digital0wave/digital0wave.github.smtoaster/README.md

# digital0wave.github.smtoaster

This is a capstone project done at BCIT.

My project partners and I proposed a remotely controlled toaster operated by Arduino. 
It has sensors that detect colour on bread and controls the toastness set by users.
Using HTTP communication, the smart toaster provides users with setting and operating it remotely.
Documents include hardware configuraton, control process, and source codes for HTTP communication.

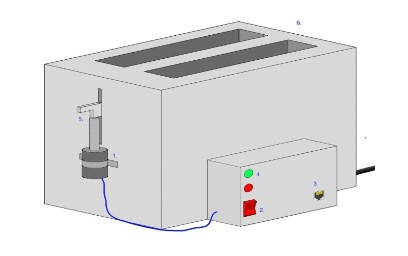
[picture p1: Doc/SMToaster_1.jpg]


## Repo 
├── README.md # This file

├── Doc    # Report and design specs

└── Codes       # Source codes for the firmware
