digital0wave/digital0wave.github.smtoaster/Codes/Doc/division labor.gif

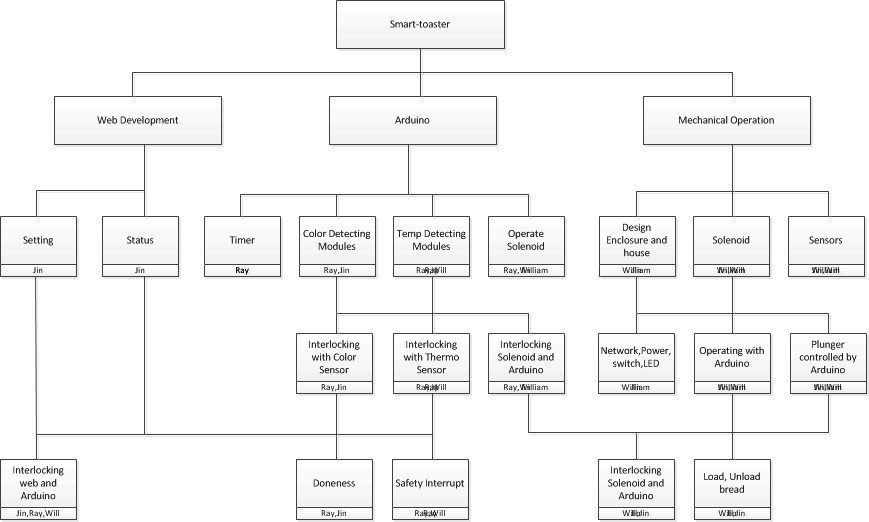
Codes/Doc/division labor.gif
