digital0wave/digital0wave.github.smtoaster/Doc/SmartToaster_C.pdf

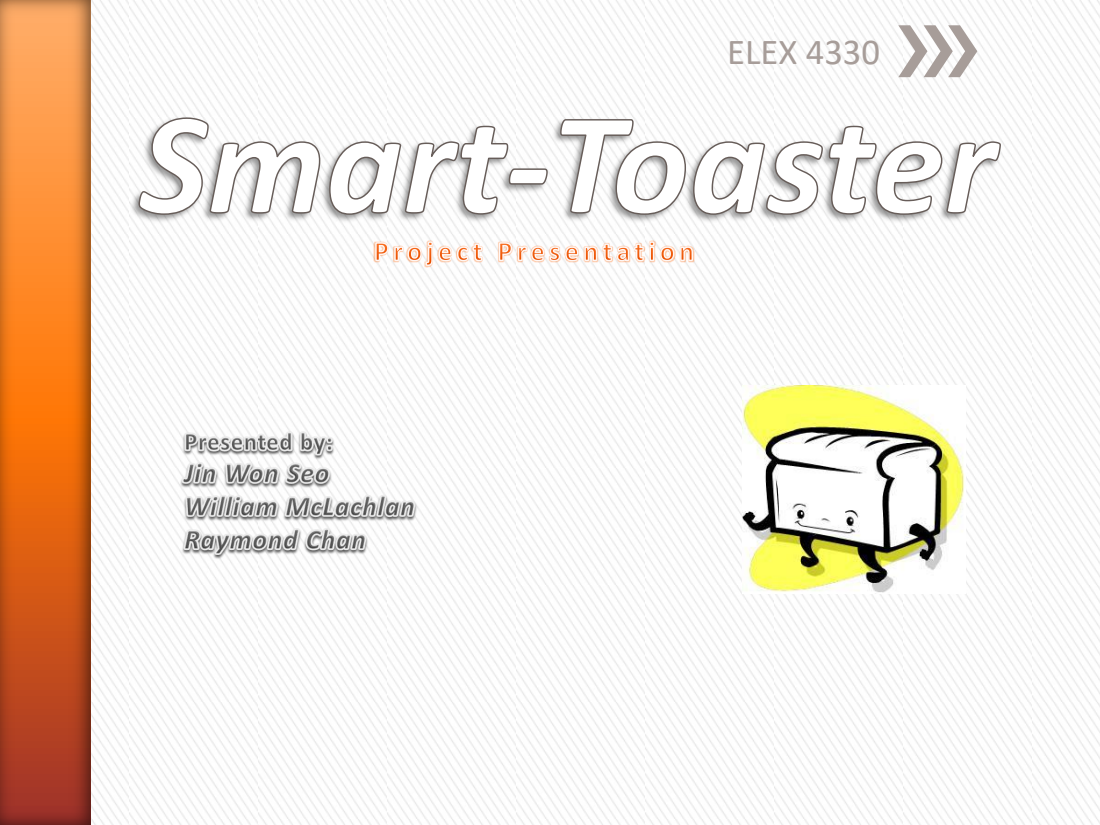
[picture p44: page 1]
ELEX 4330

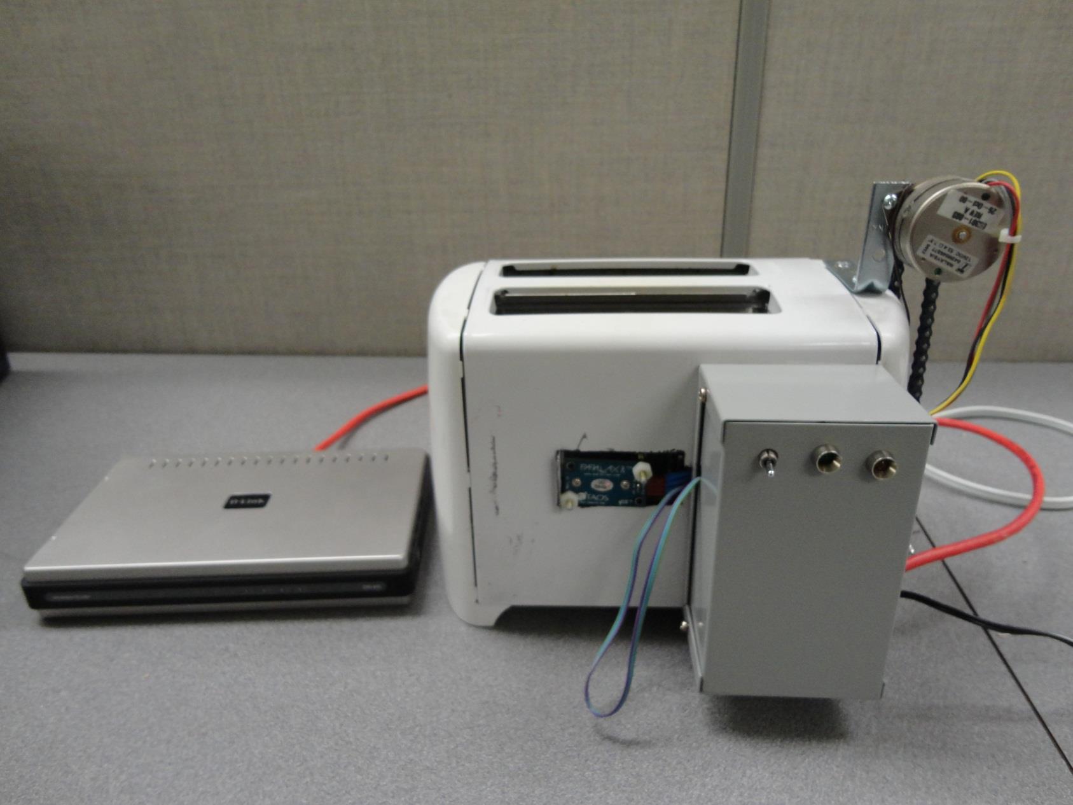
[picture p45: figure]
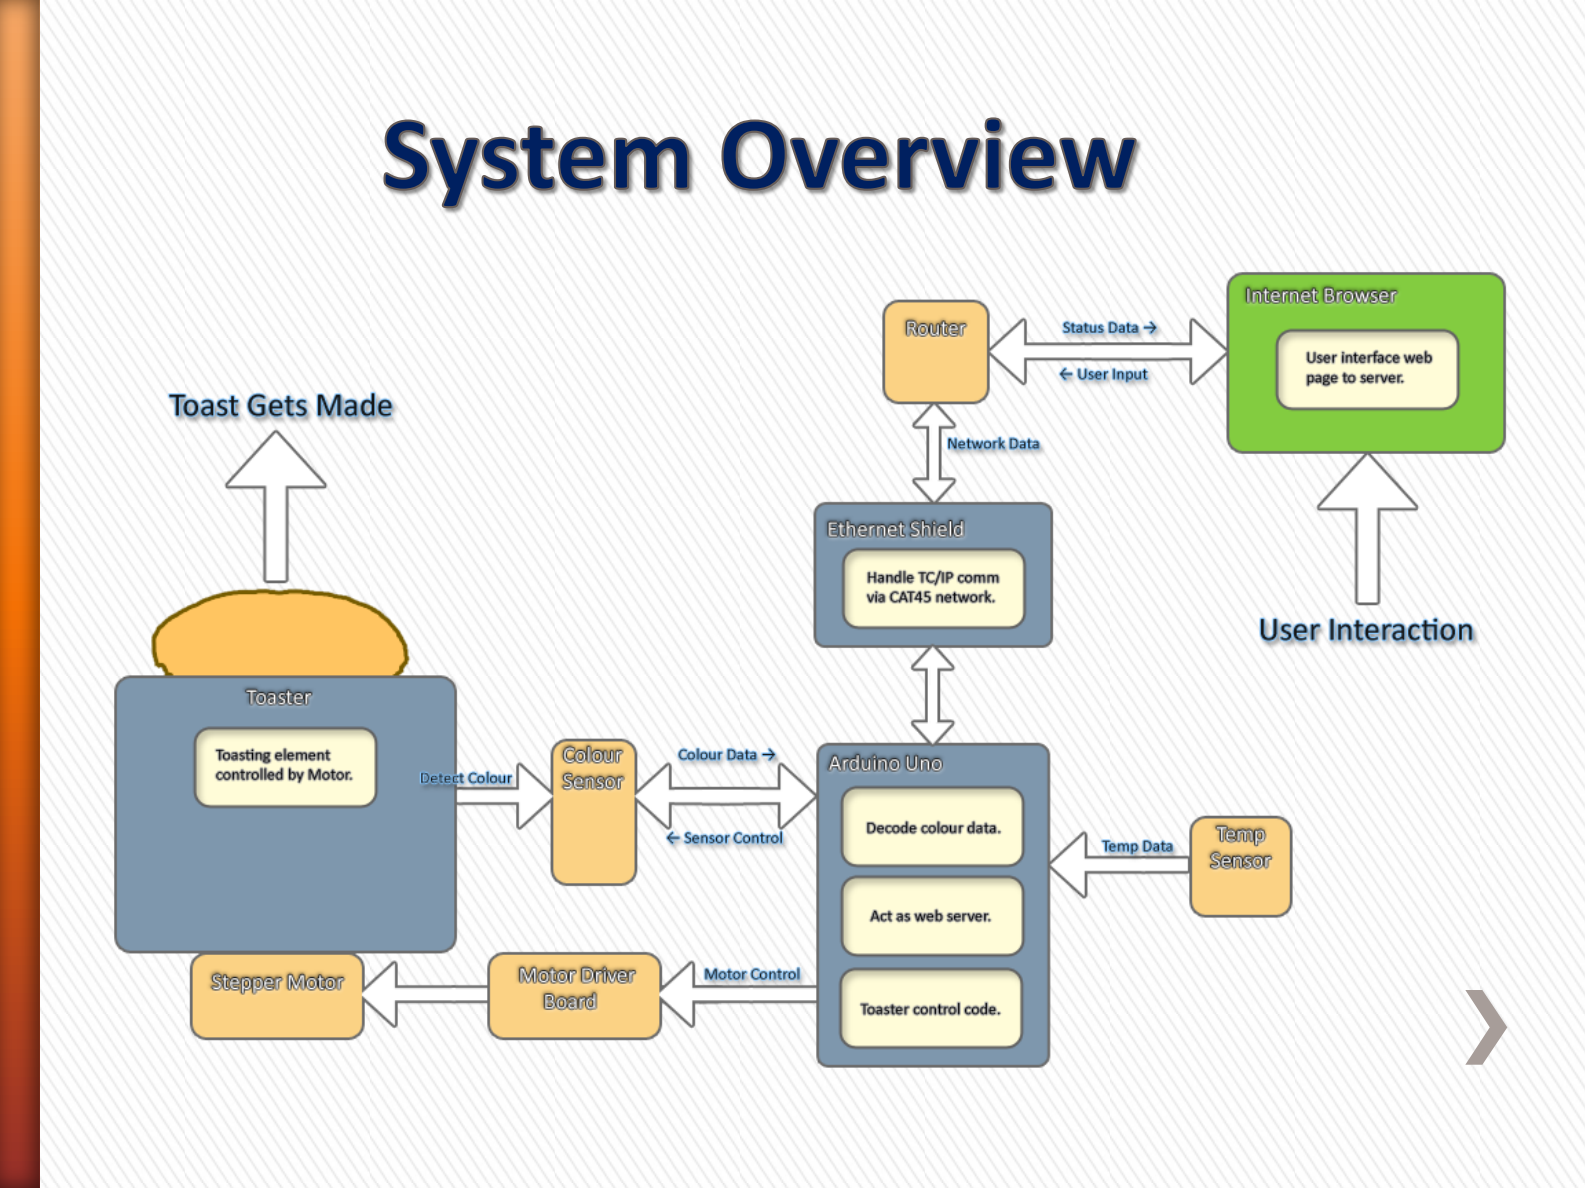
[picture p46: page 3]

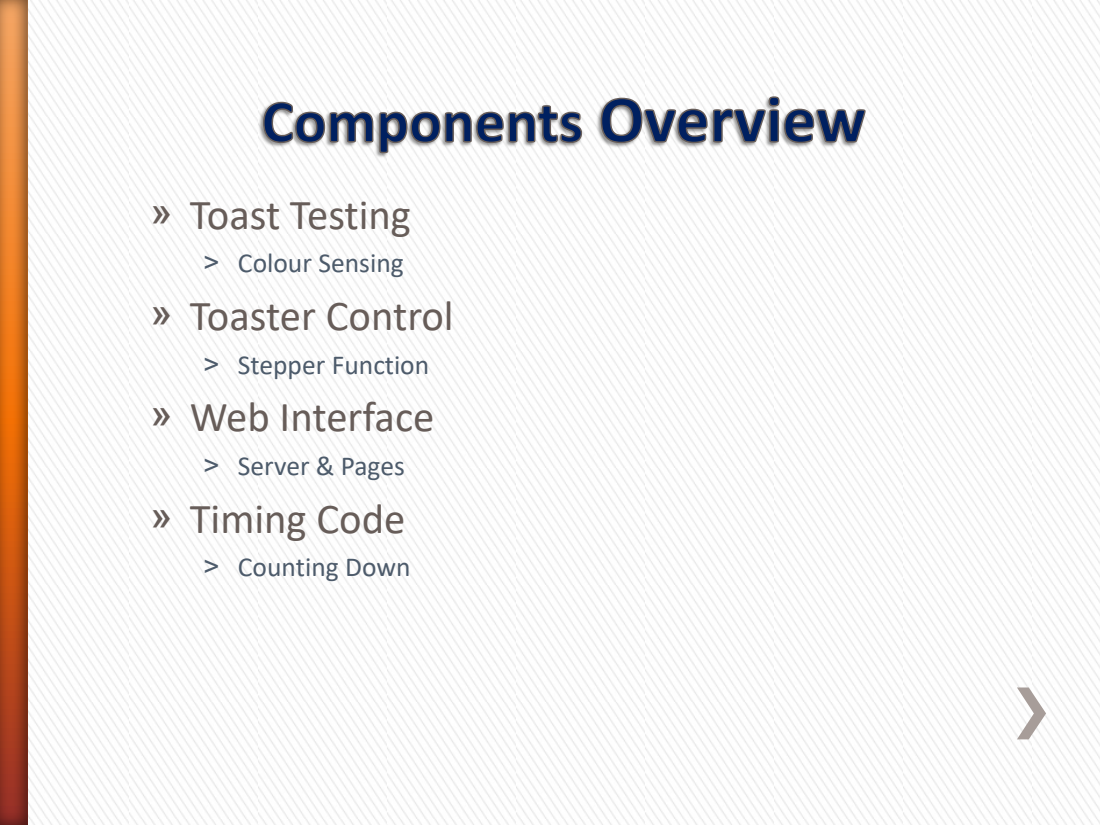
[picture p47: page 4]
» Toast Testing; ˃ Colour Sensing » Toaster Control; ˃ Stepper Function » Web Interface; ˃ Server & Pages » Timing Code; ˃ Counting Down

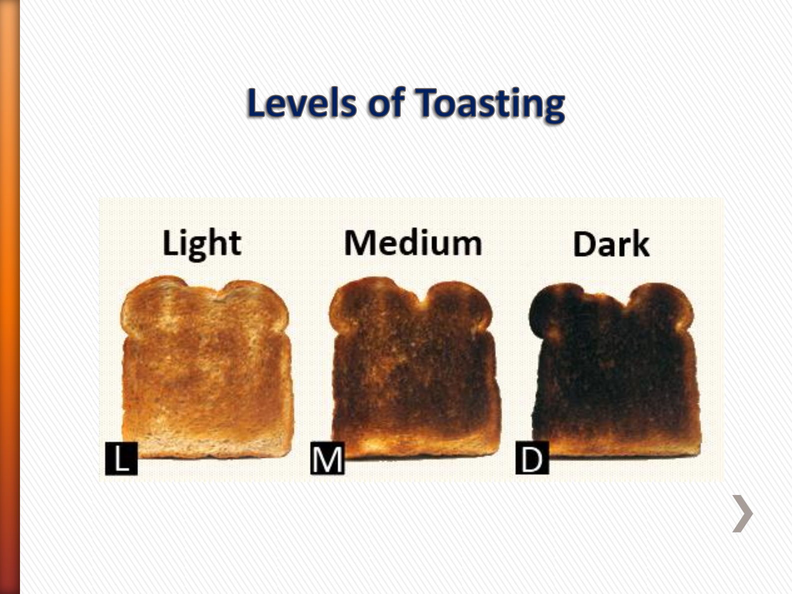
[picture p48: page 5]

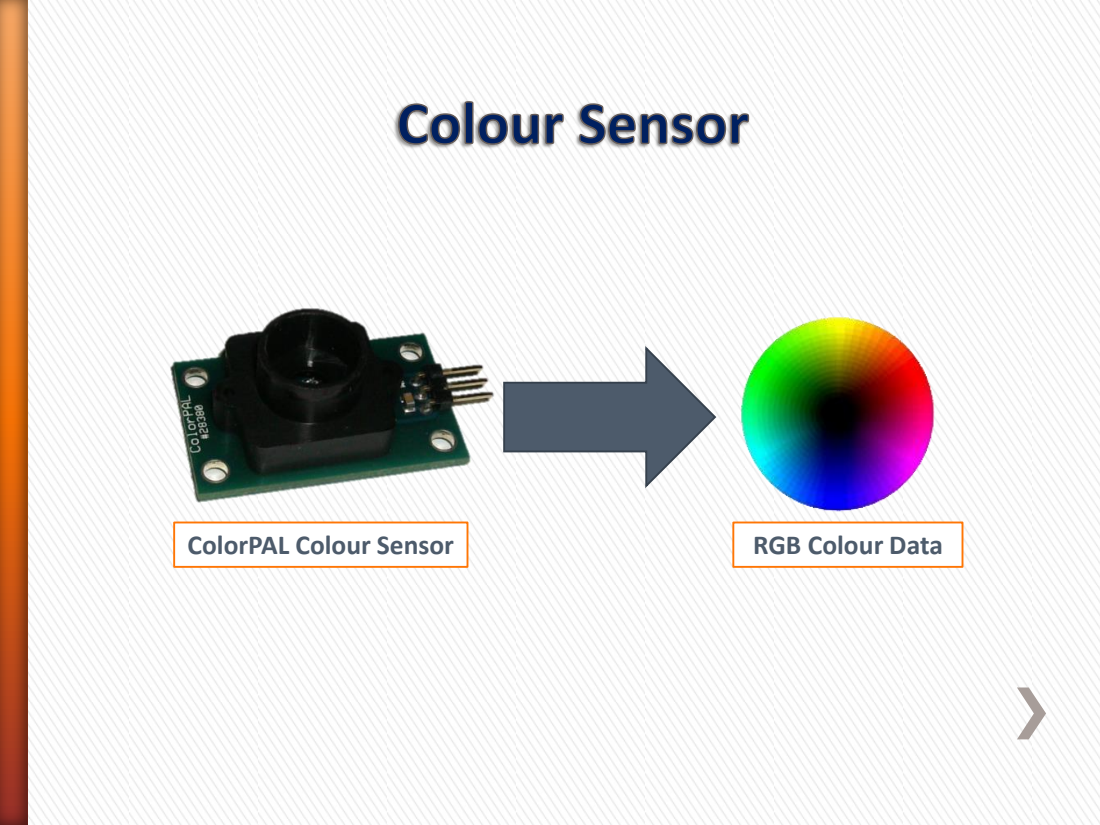
[picture p49: page 6]
ColorPAL Colour Sensor; RGB Colour Data

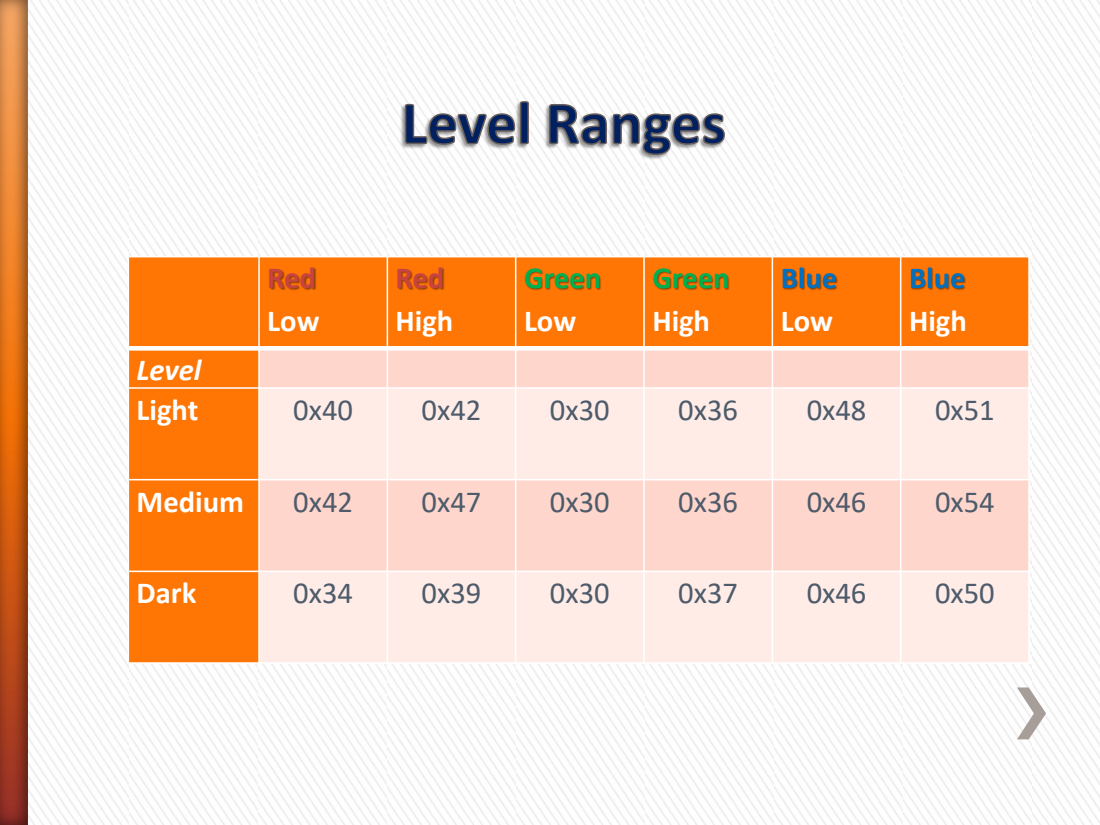
[picture p50: page 7]

Red Low | Red High | Green Low | Green High | Blue Low | Blue High

Level
Light | 0x40 | 0x42 | 0x30 | 0x36 | 0x48 | 0x51

Medium | 0x42 | 0x47 | 0x30 | 0x36 | 0x46 | 0x54

Dark | 0x34 | 0x39 | 0x30 | 0x37 | 0x46 | 0x50

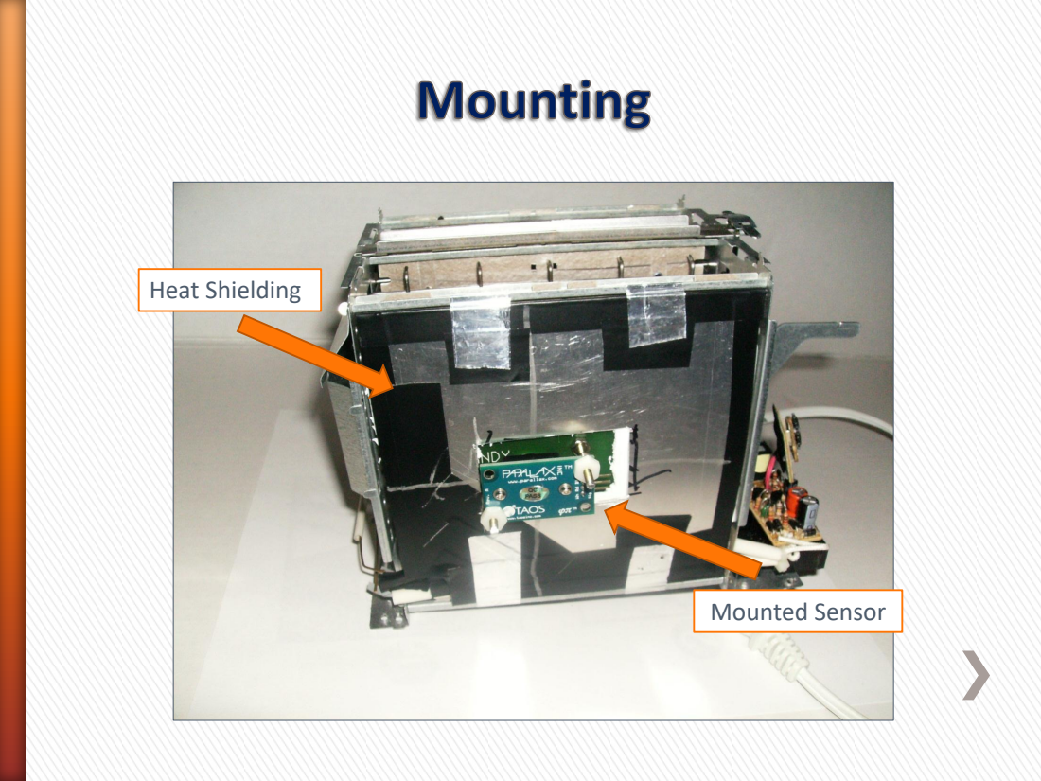
[picture p51: page 8]
Heat Shielding; Mounted Sensor

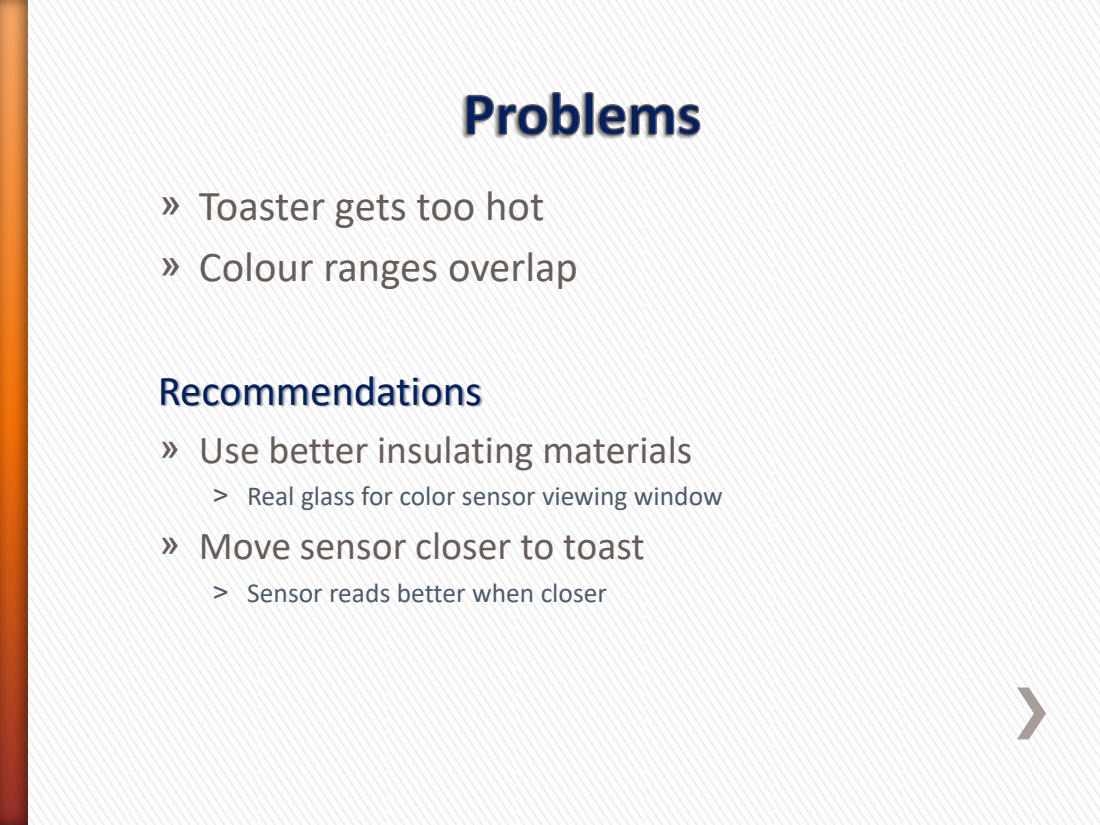
[picture p52: page 9]

» Toaster gets too hot
» Colour ranges overlap

Recommendations
» Use better insulating materials
˃ Real glass for color sensor viewing window
» Move sensor closer to toast
˃ Sensor reads better when closer

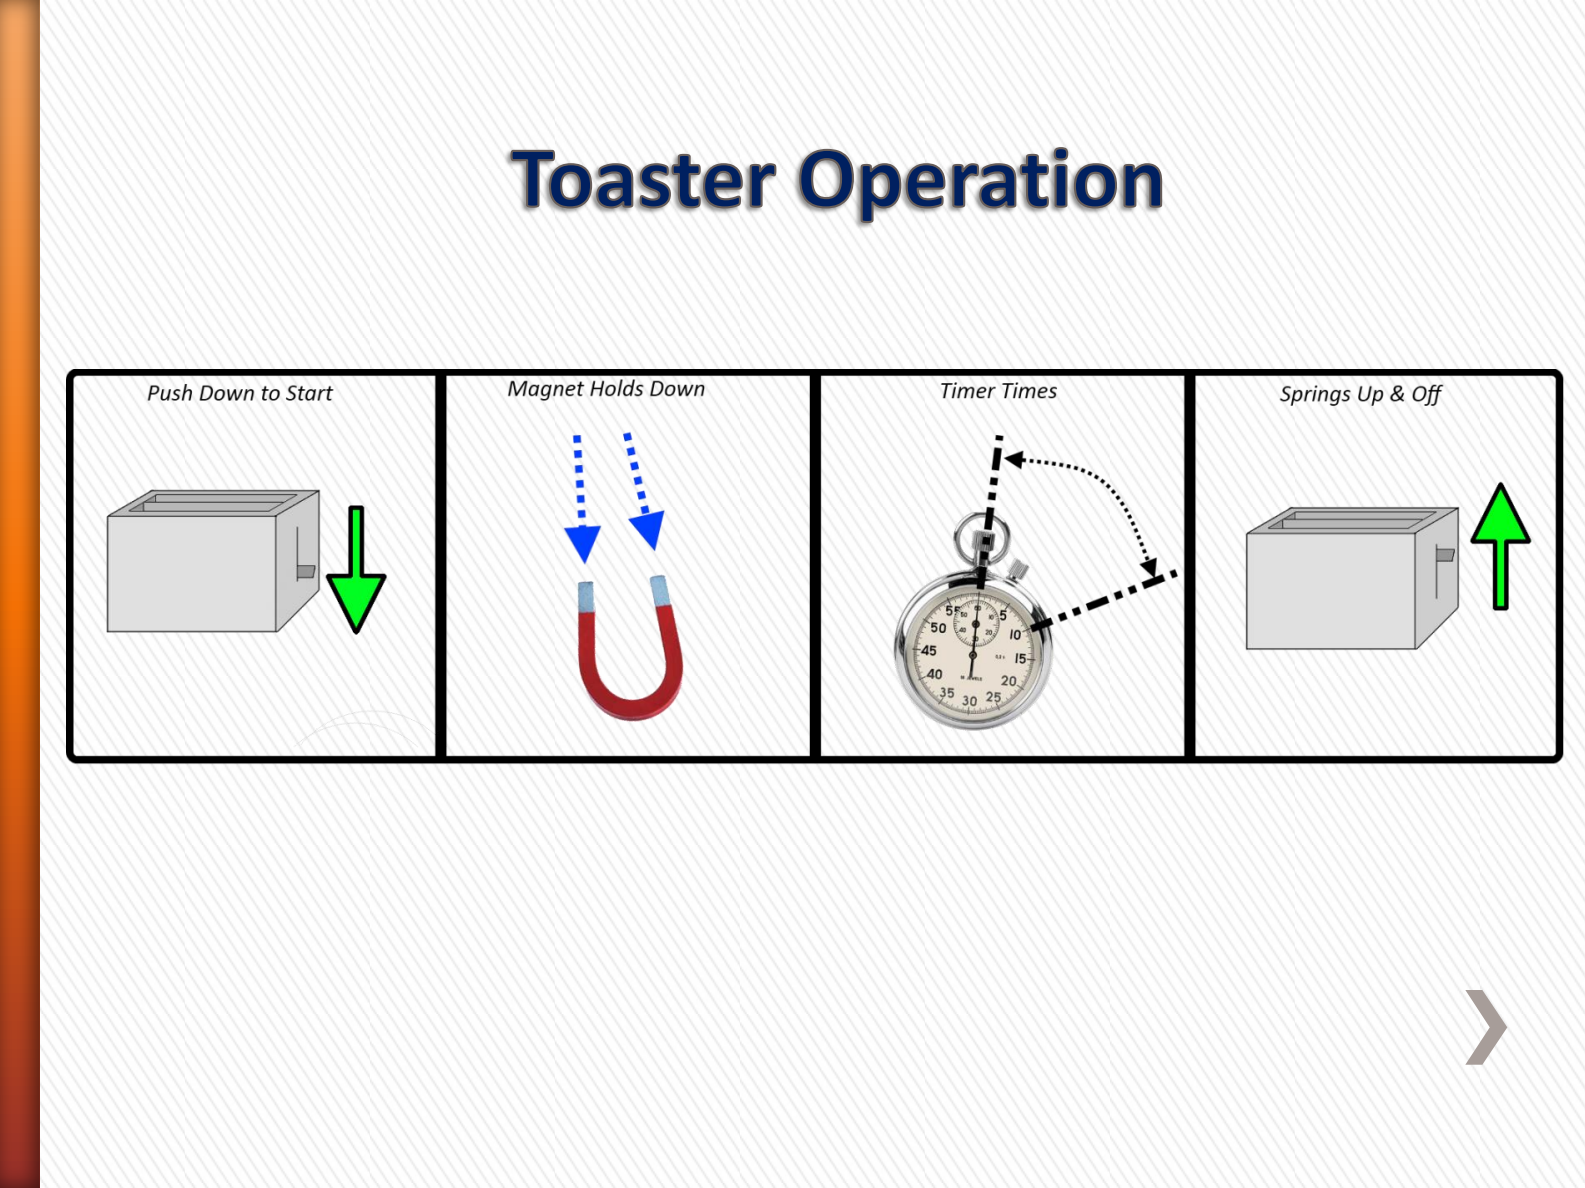
[picture p53: page 10]

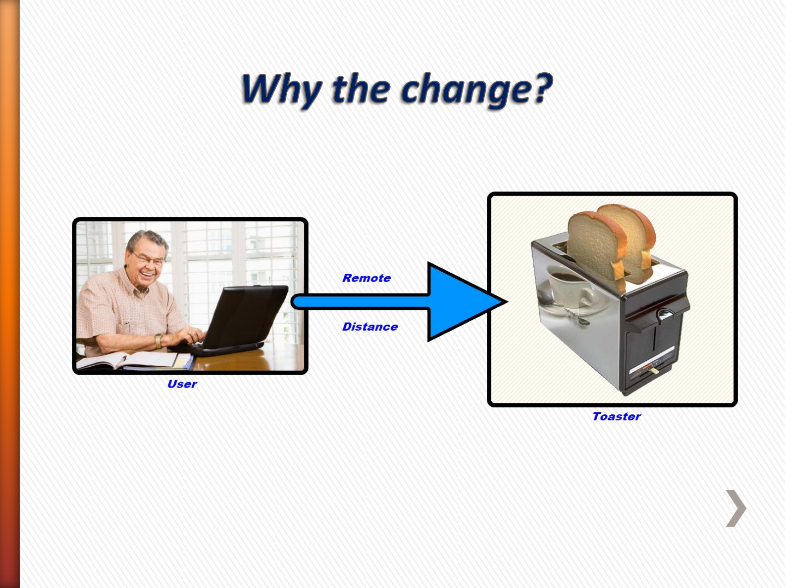
[picture p54: page 11]

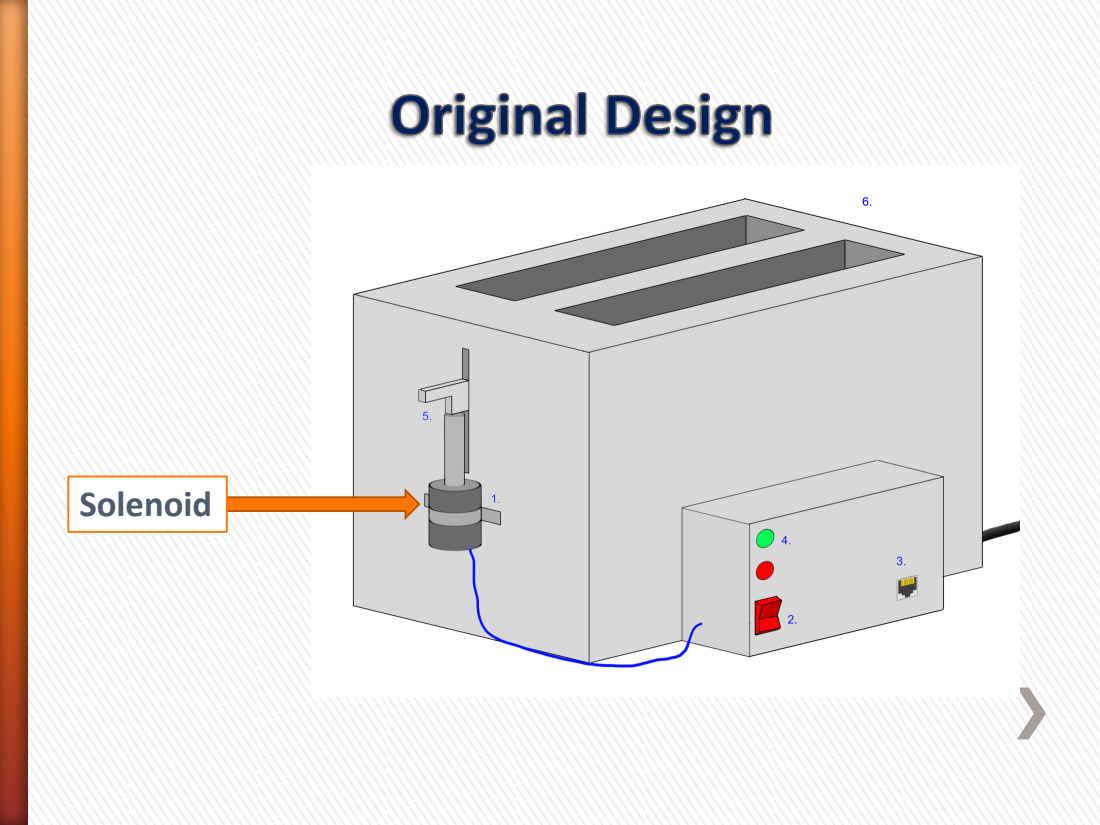
[picture p55: page 12]
Solenoid

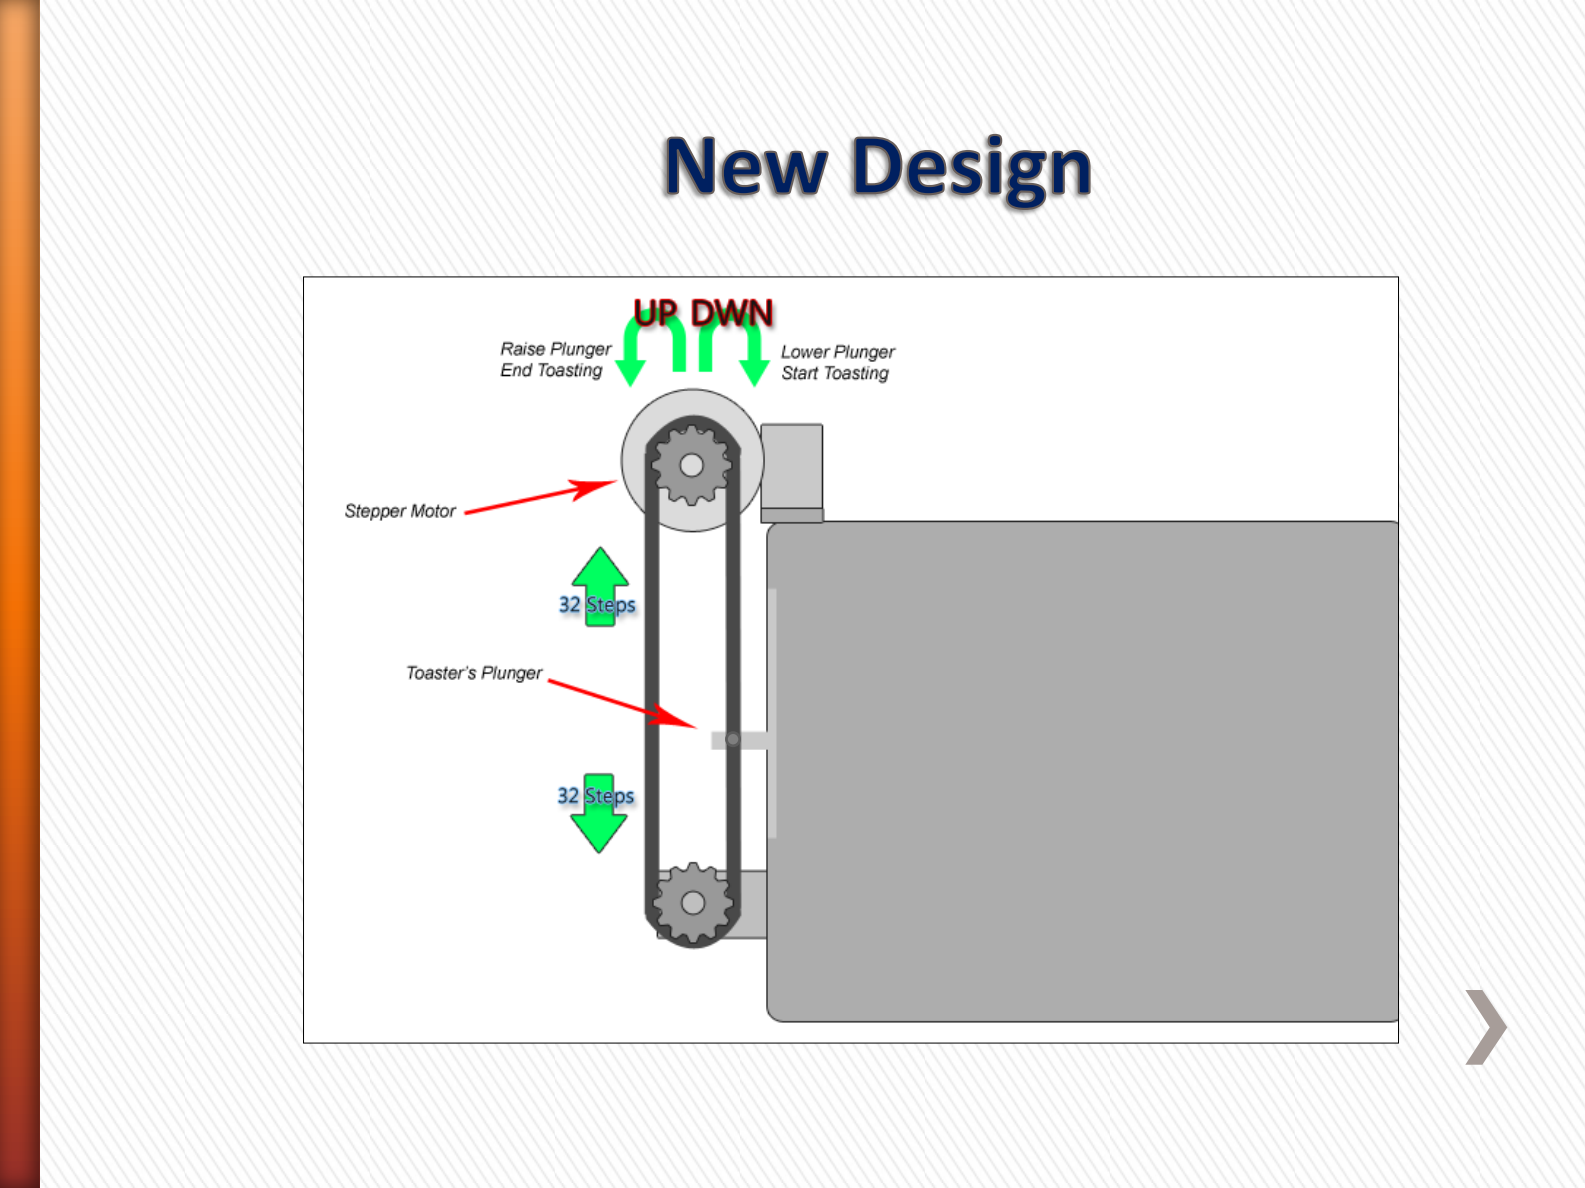
[picture p56: page 13]

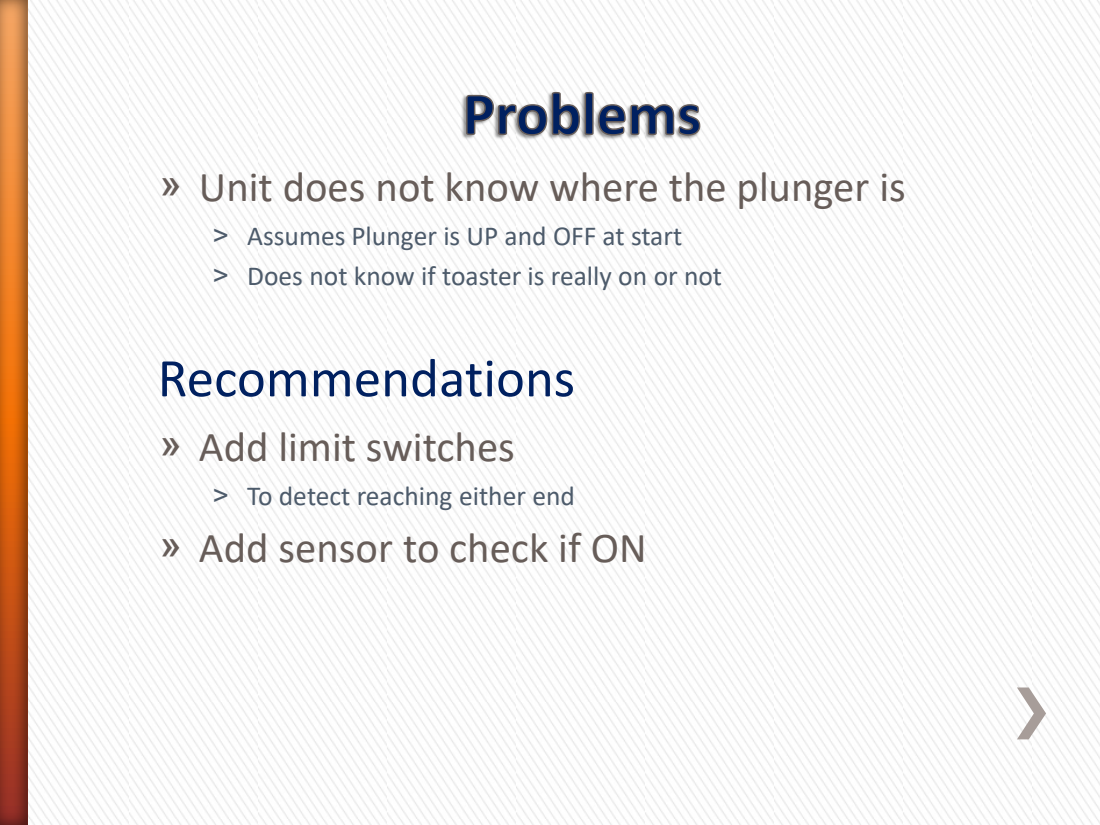
[picture p57: page 14]

» Unit does not know where the plunger is

˃ Assumes Plunger is UP and OFF at start
˃ Does not know if toaster is really on or not
Recommendations
» Add limit switches

˃ To detect reaching either end
» Add sensor to check if ON

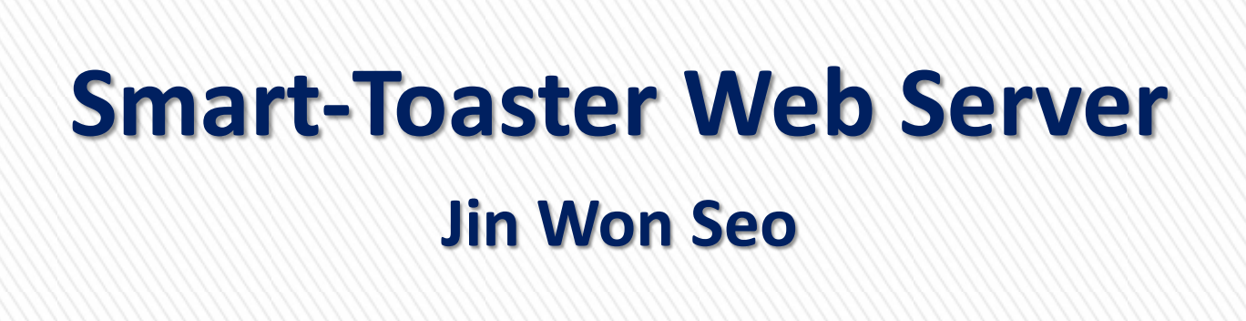
[picture p58: figure]
Smart-Toaster Web Server; Jin Won Seo
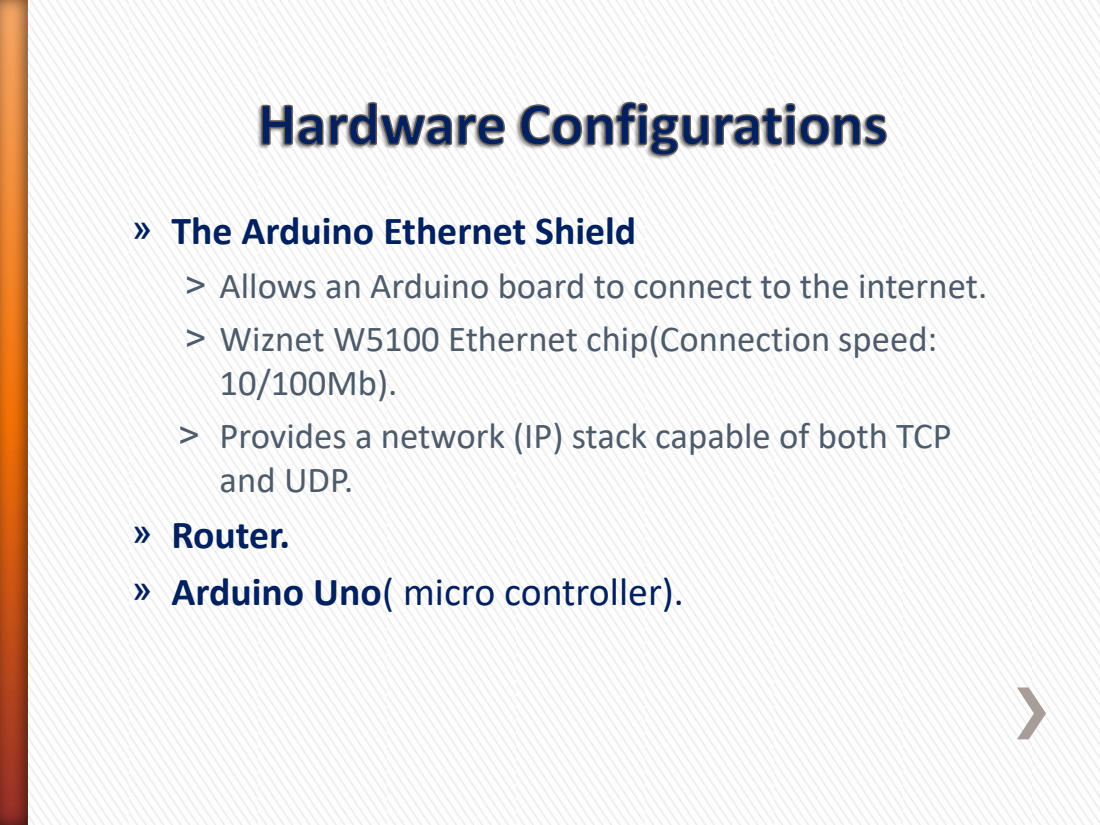
[picture p59: page 16]

» The Arduino Ethernet Shield
˃ Allows an Arduino board to connect to the internet.
˃ Wiznet W5100 Ethernet chip(Connection speed:
˃ Provides a network (IP) stack capable of both TCP
and UDP.
» Router.
» Arduino Uno( micro controller).

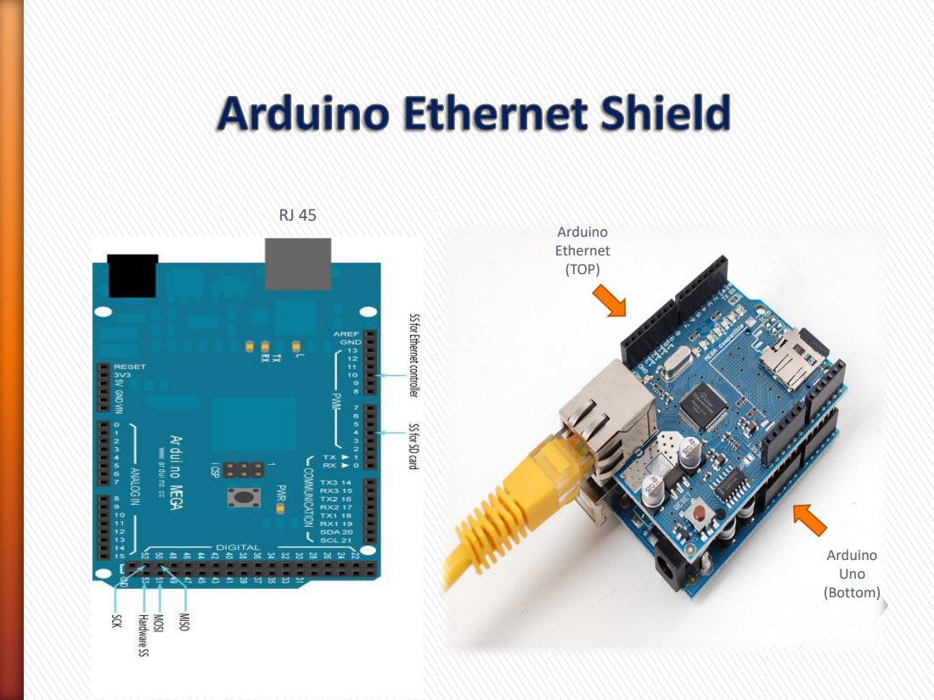
[picture p60: page 17]
Arduino Ethernet (TOP); Arduino Uno (Bottom)

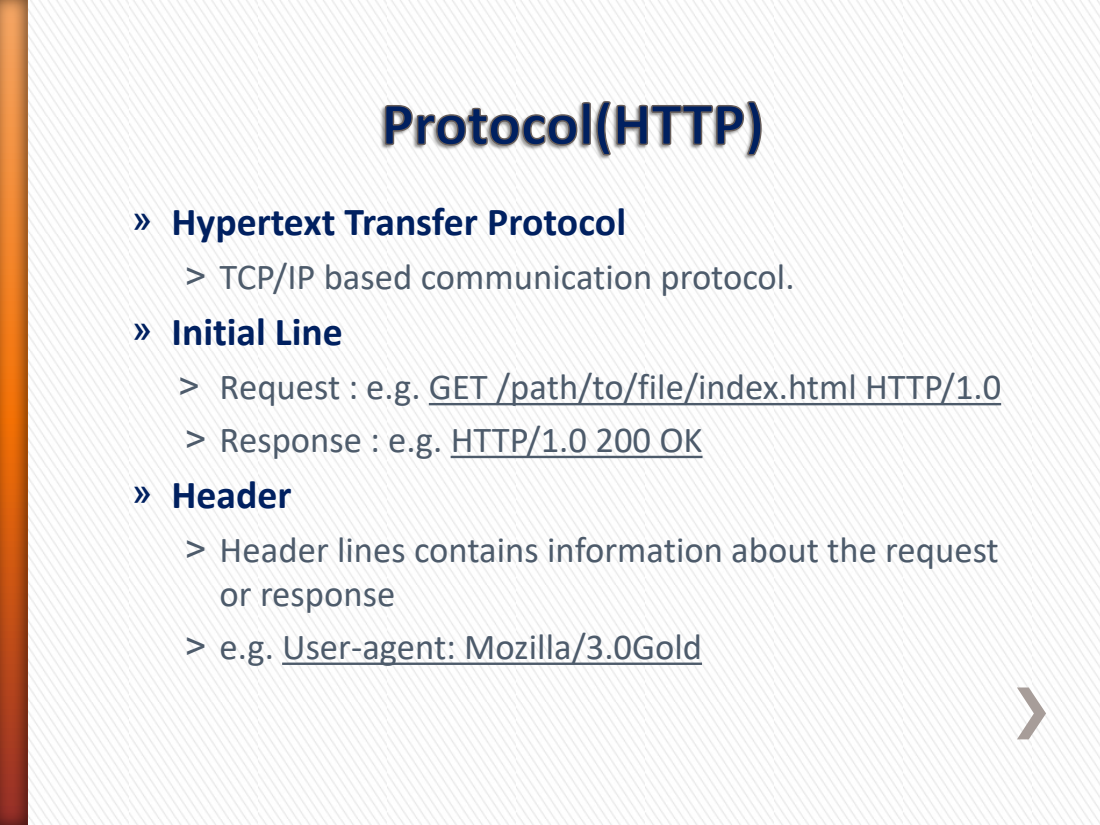
[picture p61: page 18]

» Hypertext Transfer Protocol
˃ TCP/IP based communication protocol.
» Initial Line
˃ Request : e.g. GET /path/to/file/index.html HTTP/1.0
˃ Response : e.g. HTTP/1.0 200 OK
» Header
˃ Header lines contains information about the request
or response
˃ e.g. User-agent: Mozilla/3.0Gold

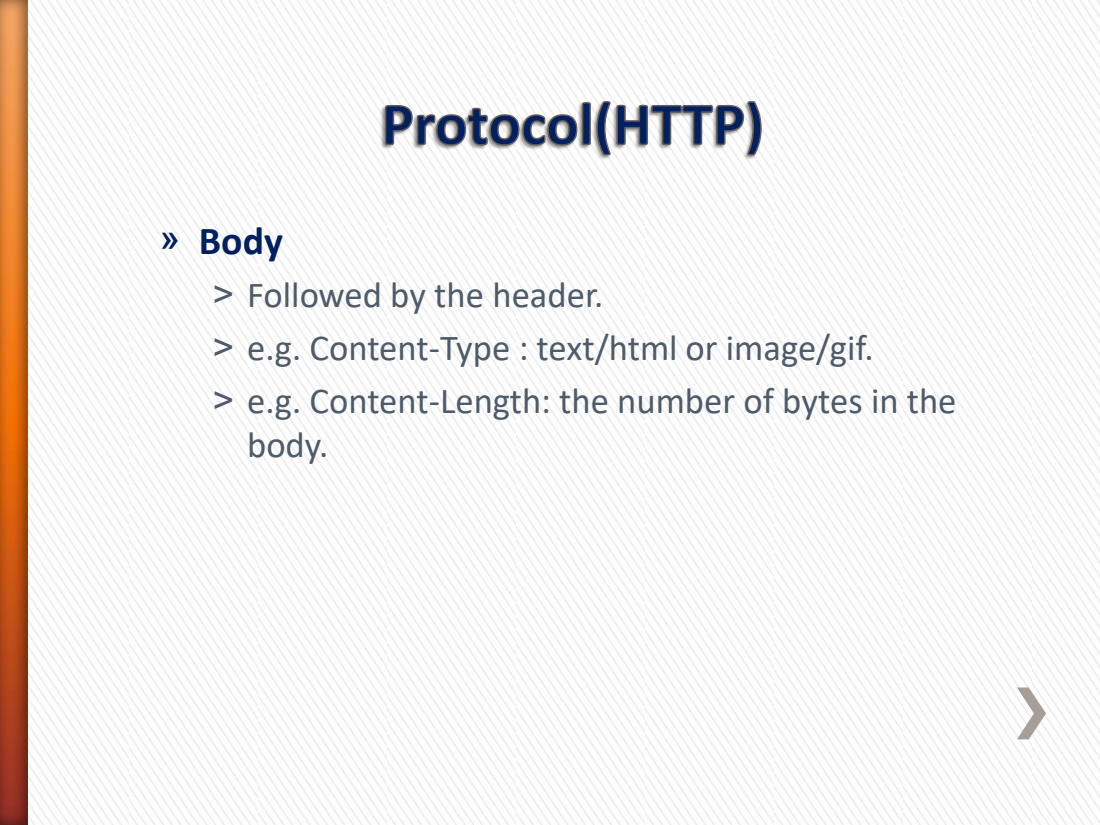
[picture p62: page 19]

» Body
˃ Followed by the header.
˃ e.g. Content-Type : text/html or image/gif.
˃ e.g. Content-Length: the number of bytes in the
body.

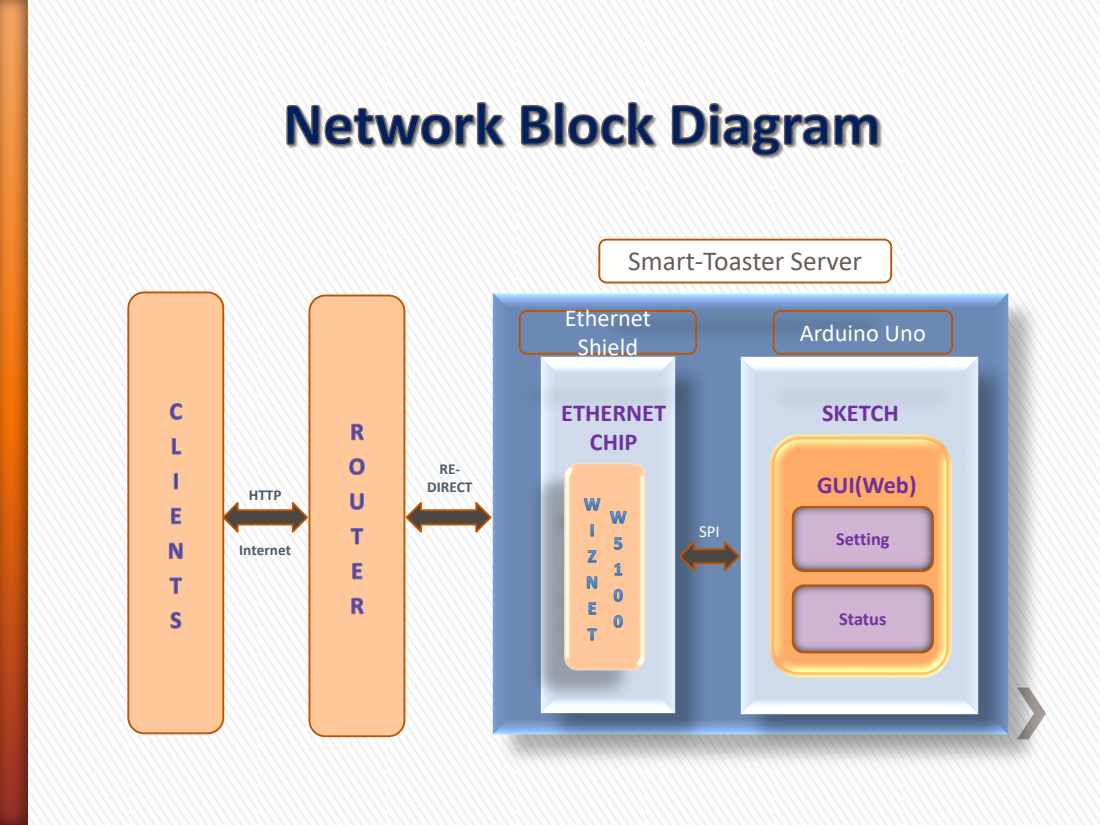
[picture p63: page 20]
GUI(Web); Setting; Status; SPI; SKETCH; Ethernet; Shield; Arduino Uno; ETHERNET CHIP; RE- DIRECT HTTP; Internet

Smart-Toaster Server

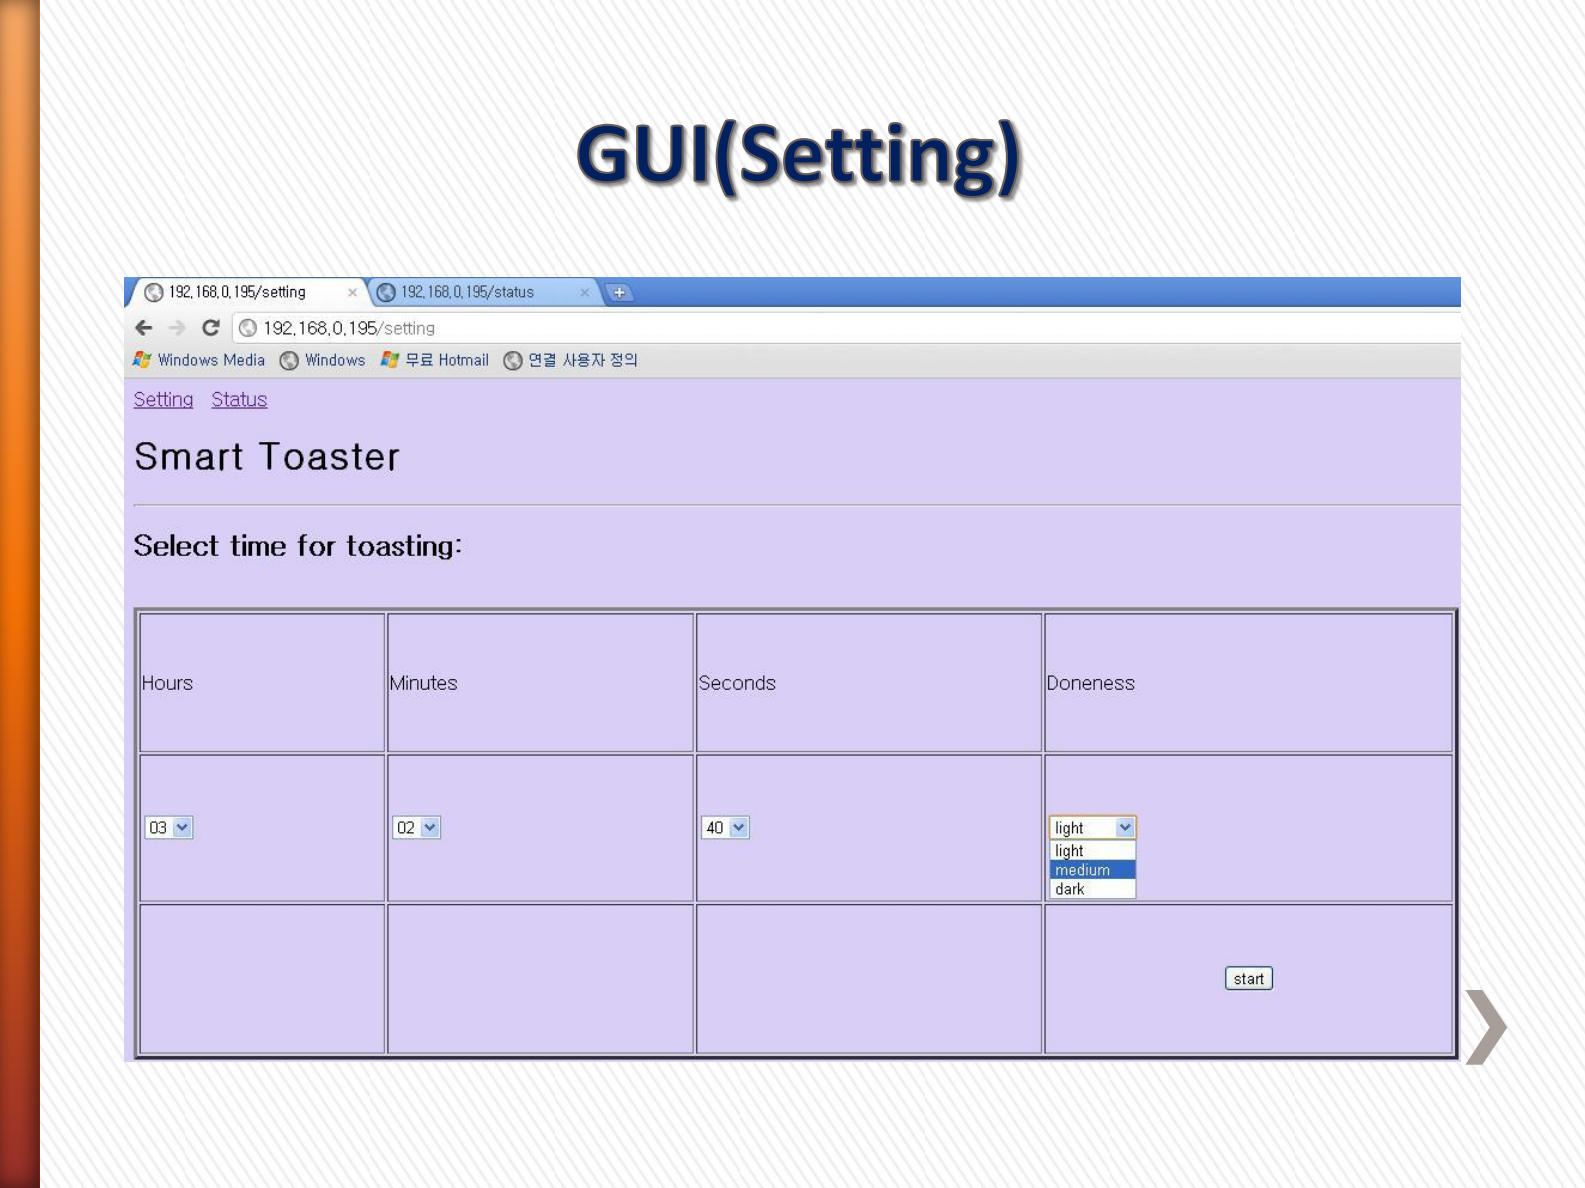
[picture p64: page 21]

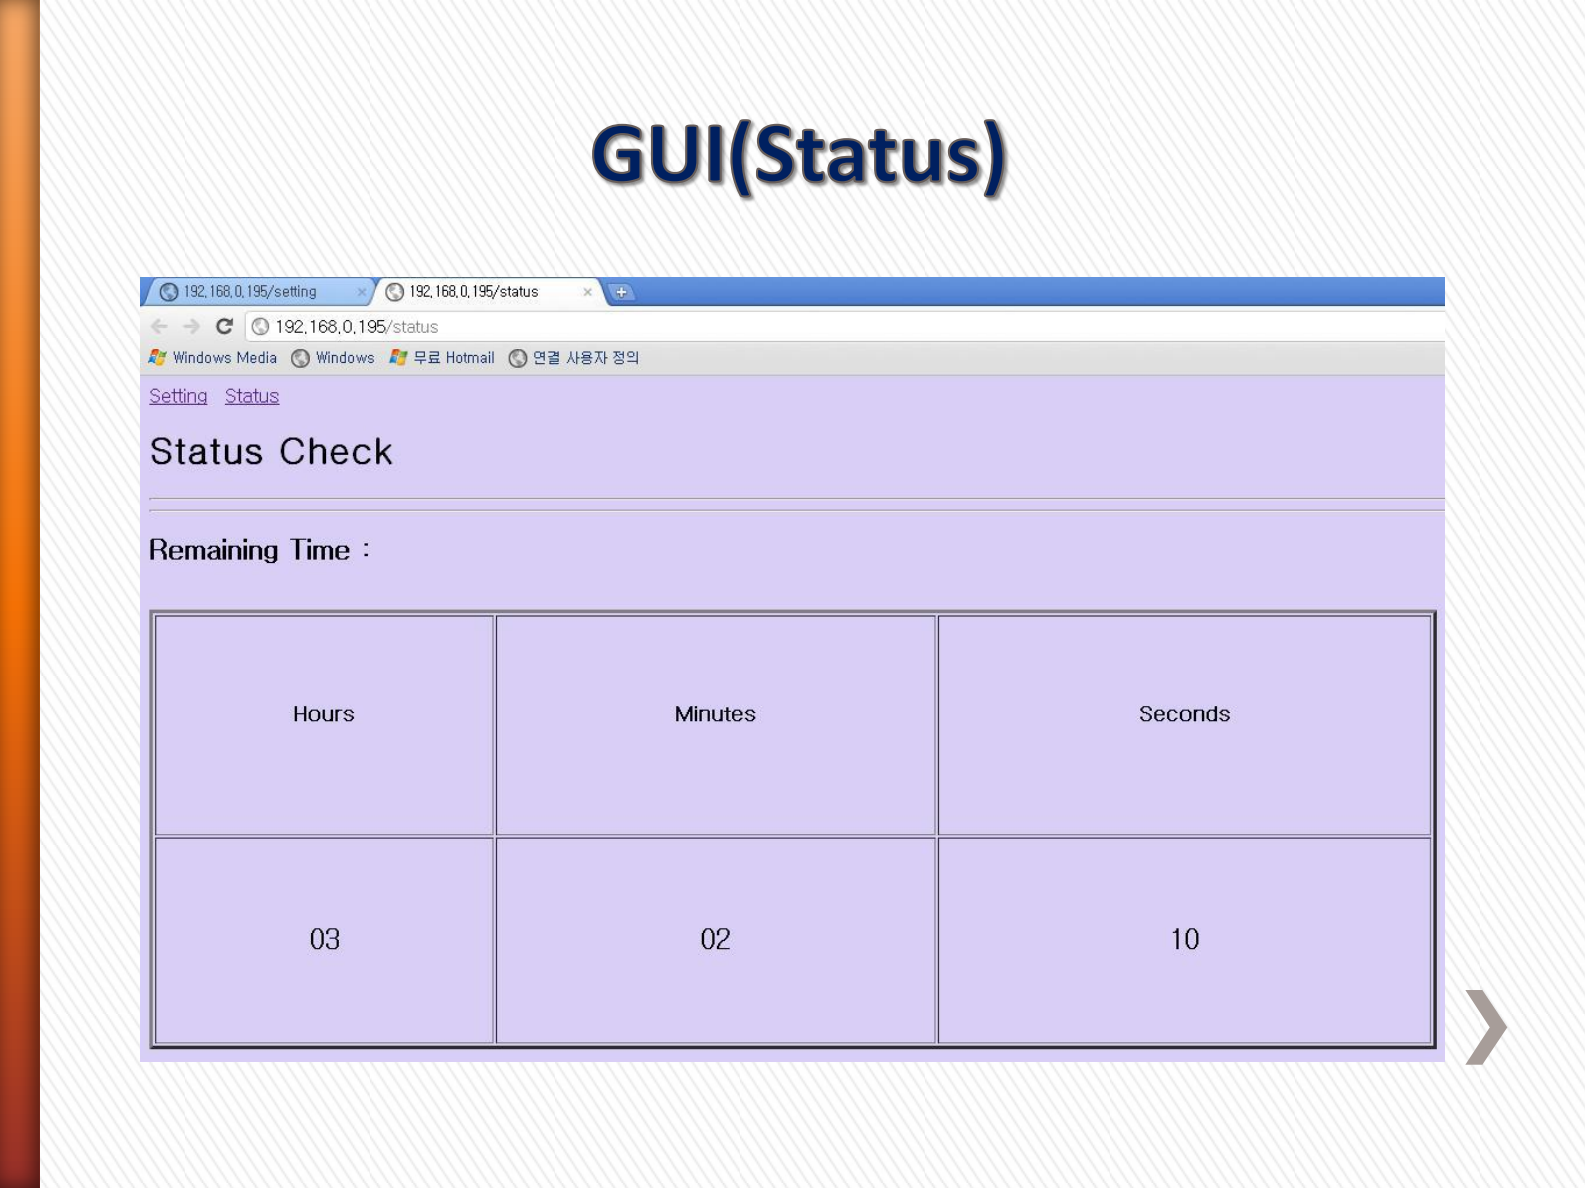
[picture p65: page 22]

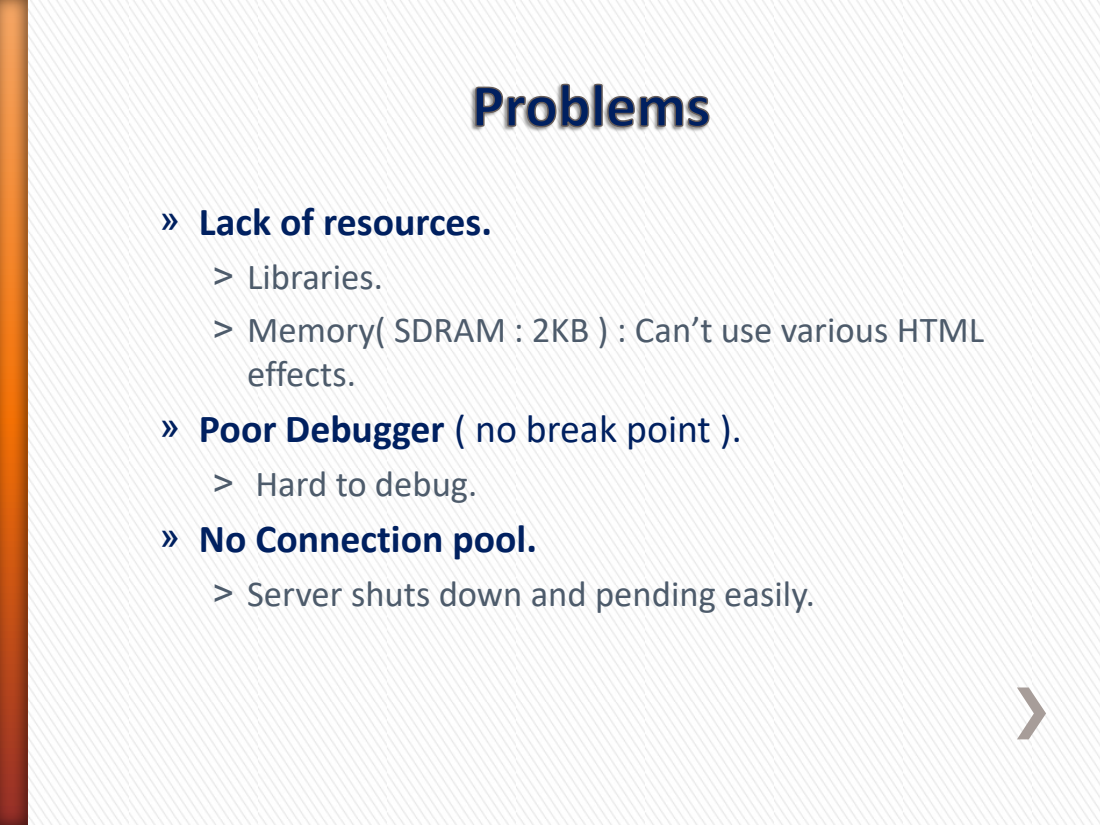
[picture p66: page 23]

» Lack of resources.
˃ Libraries.
˃ Memory( SDRAM : 2KB ) : Can’t use various HTML
effects.
» Poor Debugger ( no break point ).
˃ Hard to debug.
» No Connection pool.
˃ Server shuts down and pending easily.

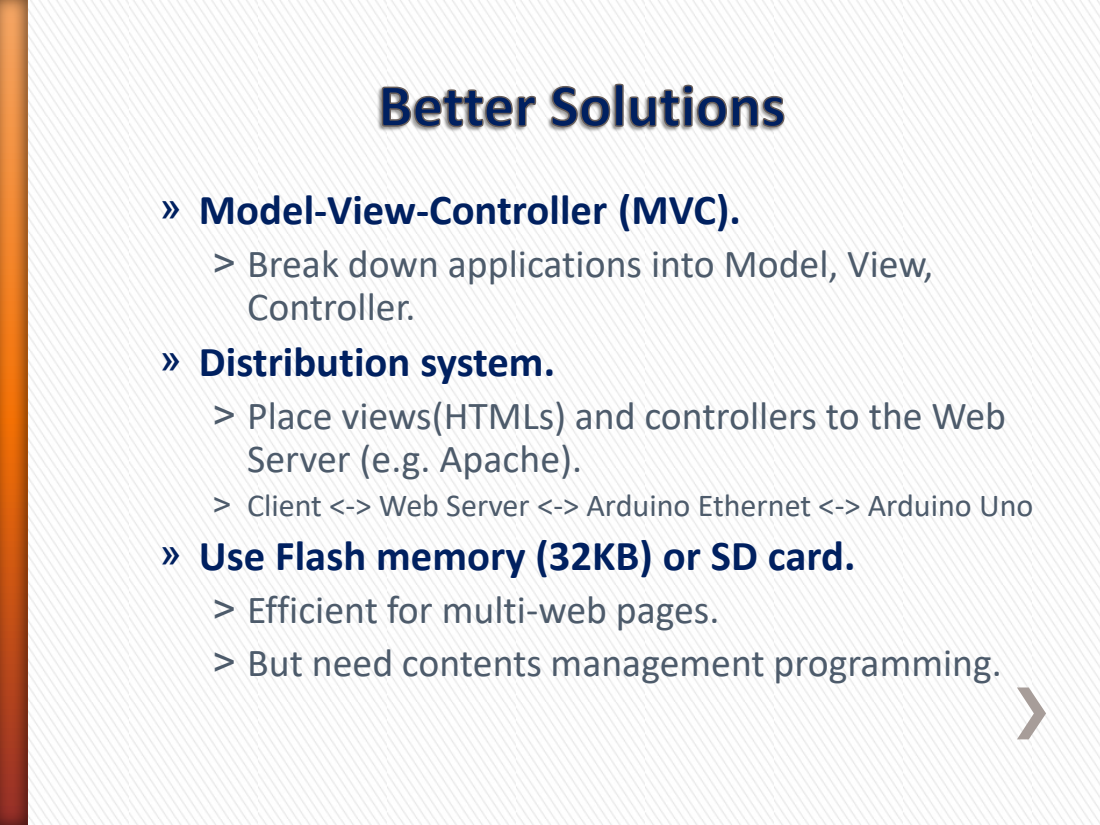
[picture p67: page 24]

» Model-View-Controller (MVC).
˃ Break down applications into Model, View,
Controller.
» Distribution system.
˃ Place views(HTMLs) and controllers to the Web
Server (e.g. Apache).
˃ Client <-> Web Server <-> Arduino Ethernet <-> Arduino Uno
» Use Flash memory (32KB) or SD card.
˃ Efficient for multi-web pages.
˃ But need contents management programming.

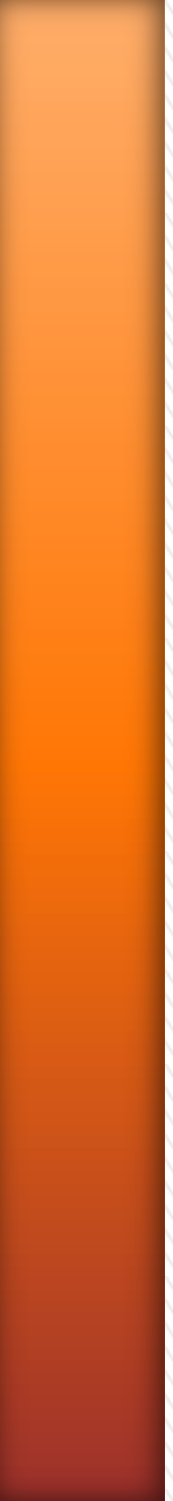
[picture p68: figure]
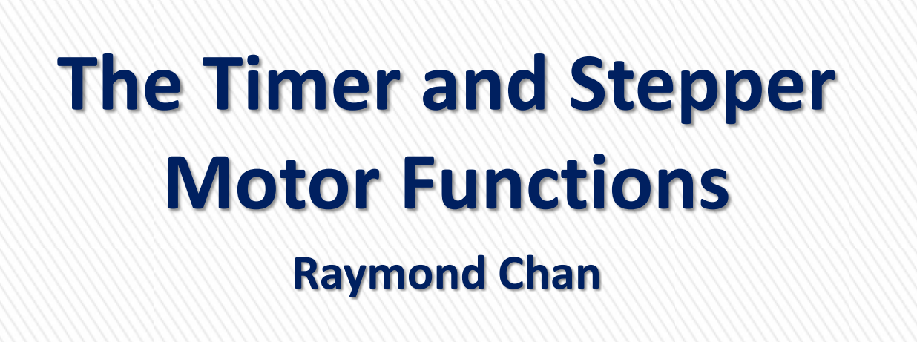
[picture p69: figure]
The Timer and Stepper Motor Functions; Raymond Chan
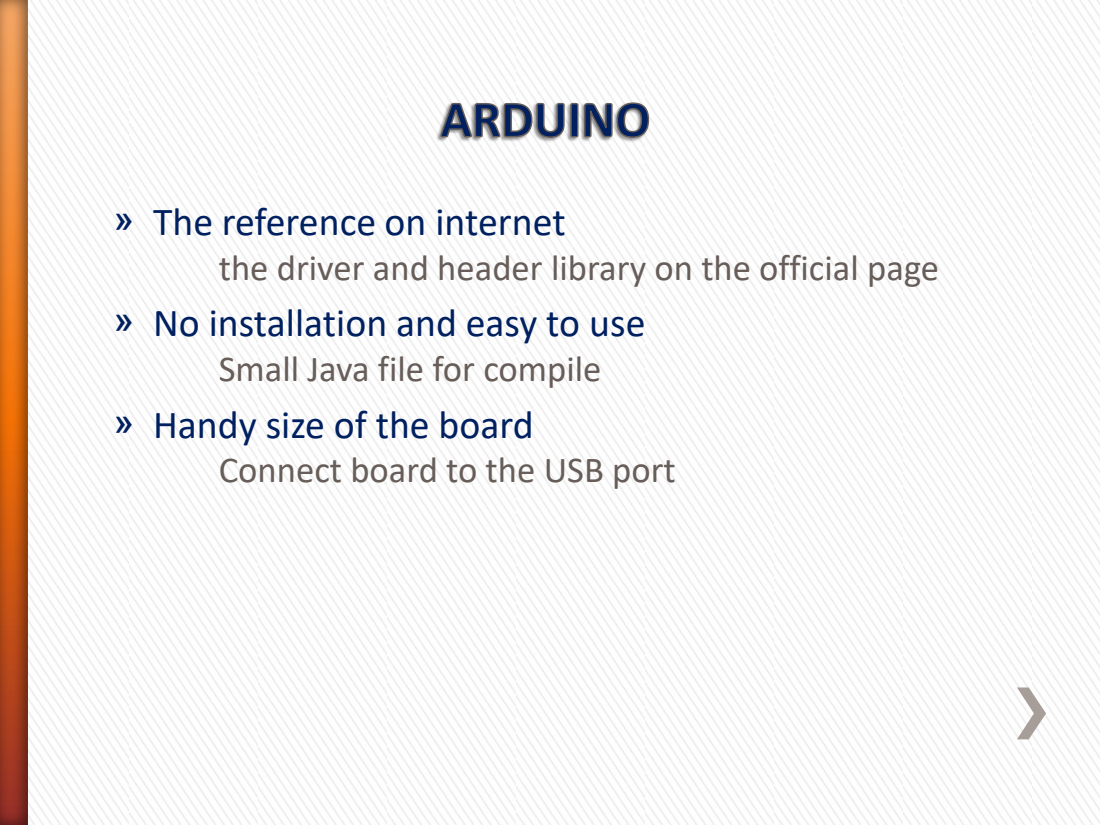
[picture p70: page 26]

» The reference on internet
the driver and header library on the official page
» No installation and easy to use
Small Java file for compile
» Handy size of the board
Connect board to the USB port

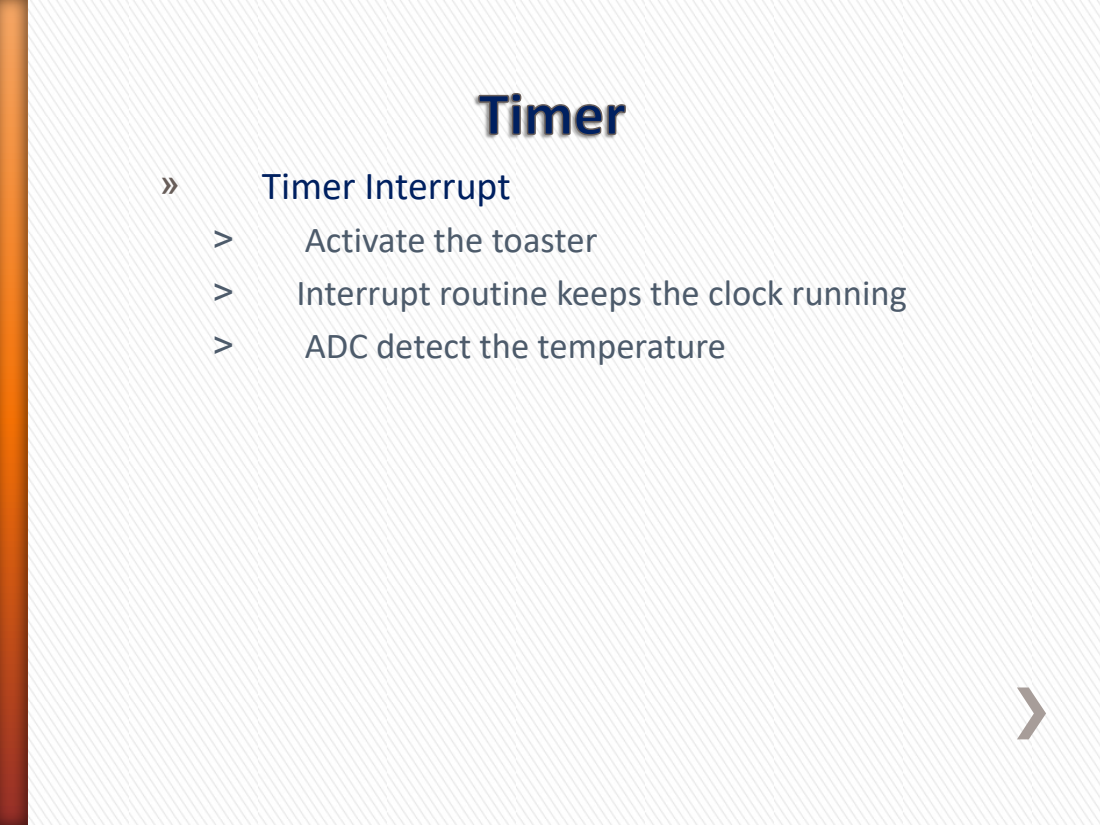
[picture p71: page 27]
Timer Interrupt; Activate the toaster; Interrupt routine keeps the clock running; ADC detect the temperature

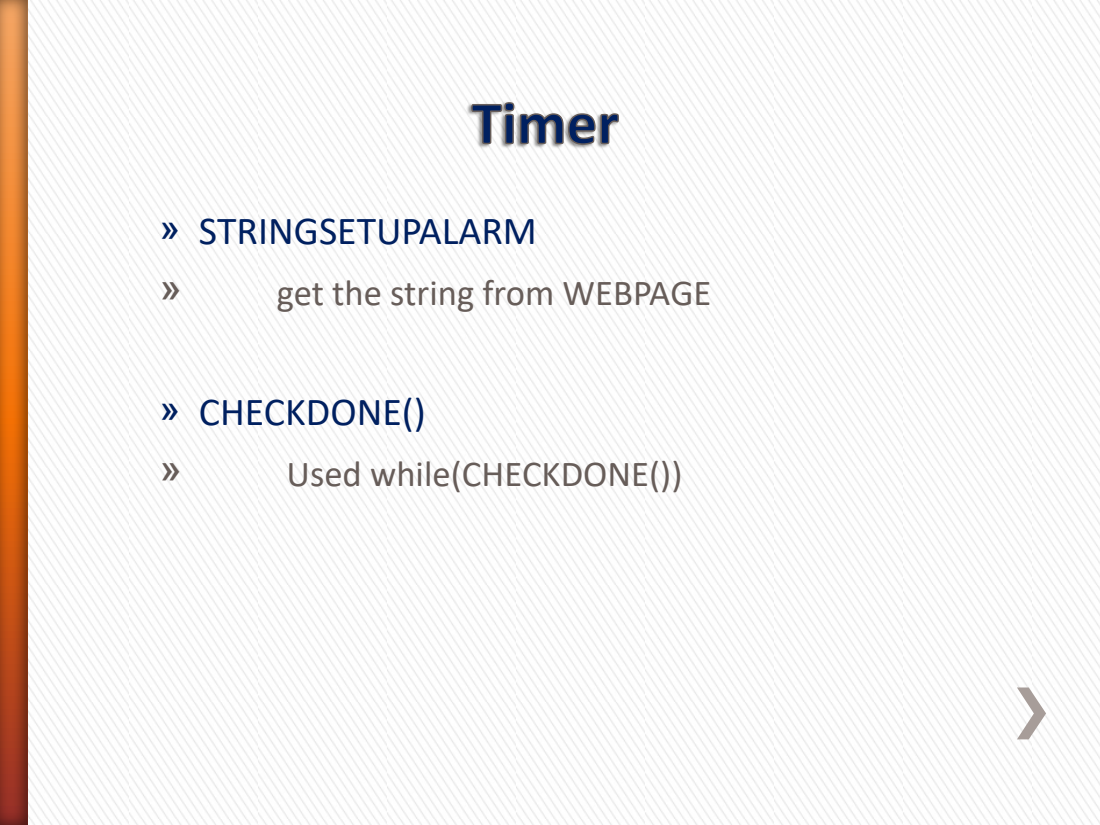
[picture p72: page 28]
» STRINGSETUPALARM; get the string from WEBPAGE; » CHECKDONE(); Used while(CHECKDONE())

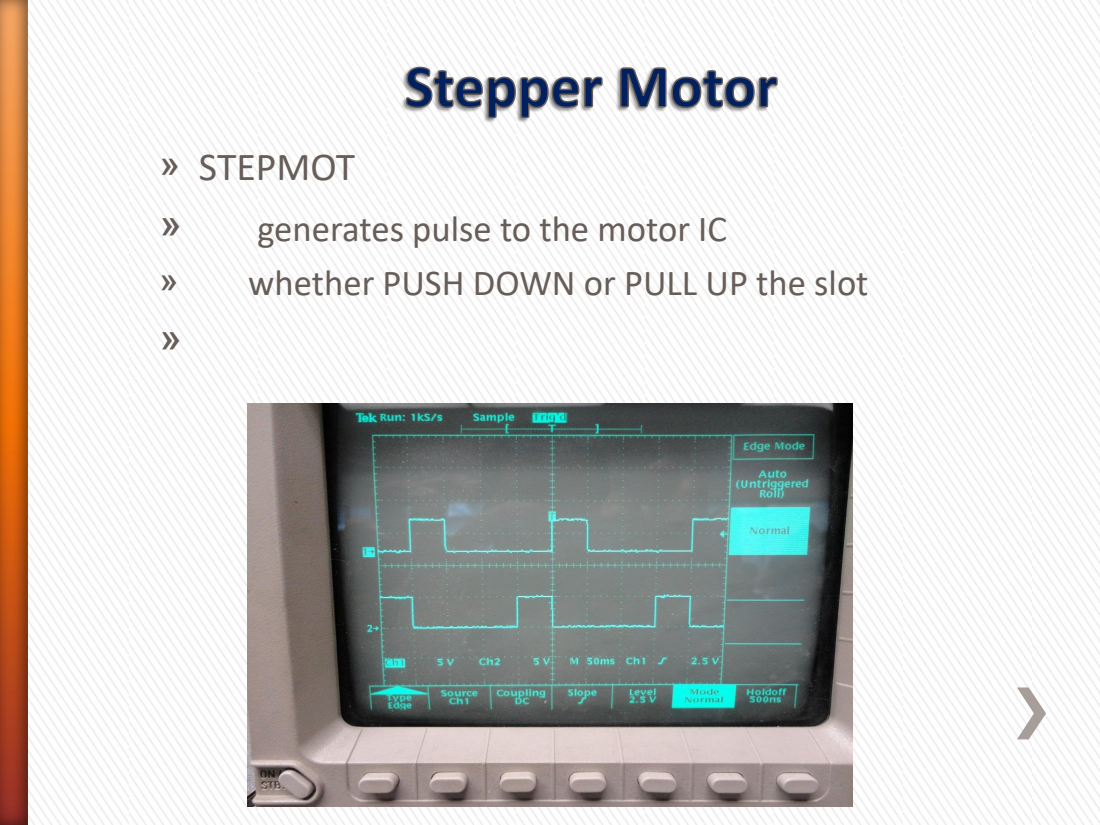
[picture p73: page 29]
» STEPMOT; generates pulse to the motor IC; whether PUSH DOWN or PULL UP the slot

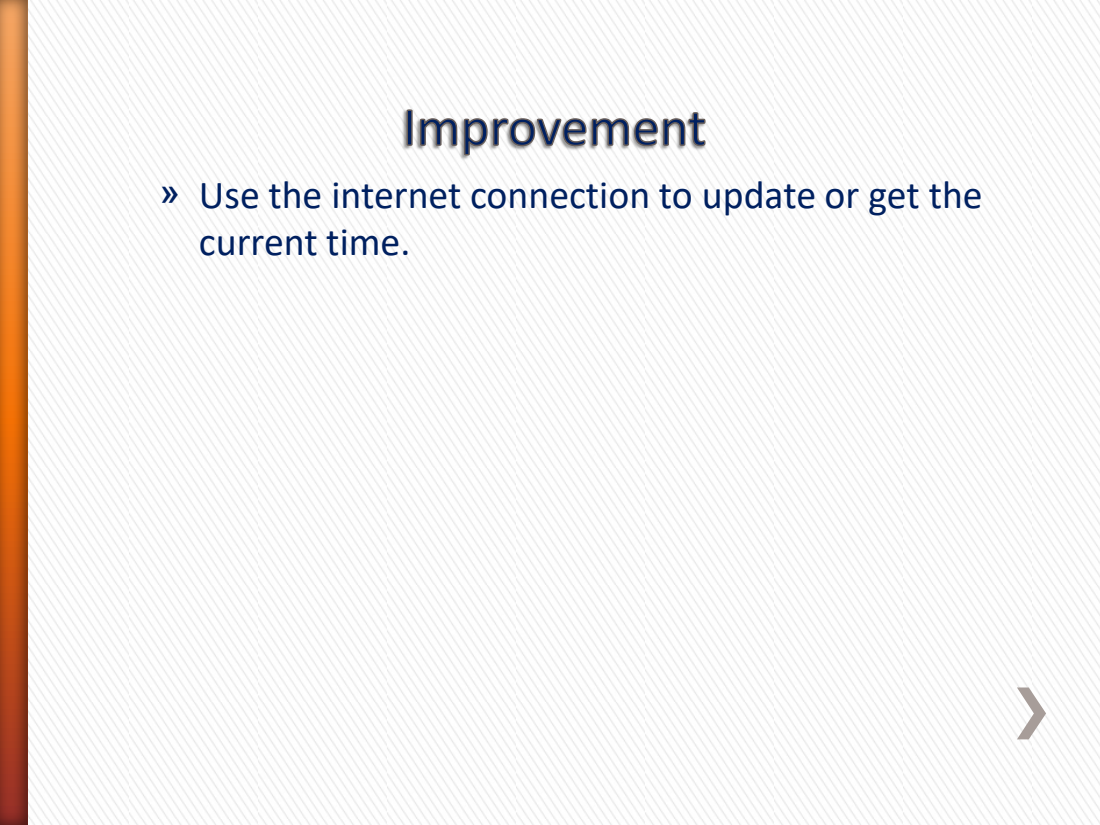
[picture p74: page 30]

» Use the internet connection to update or get the
current time.

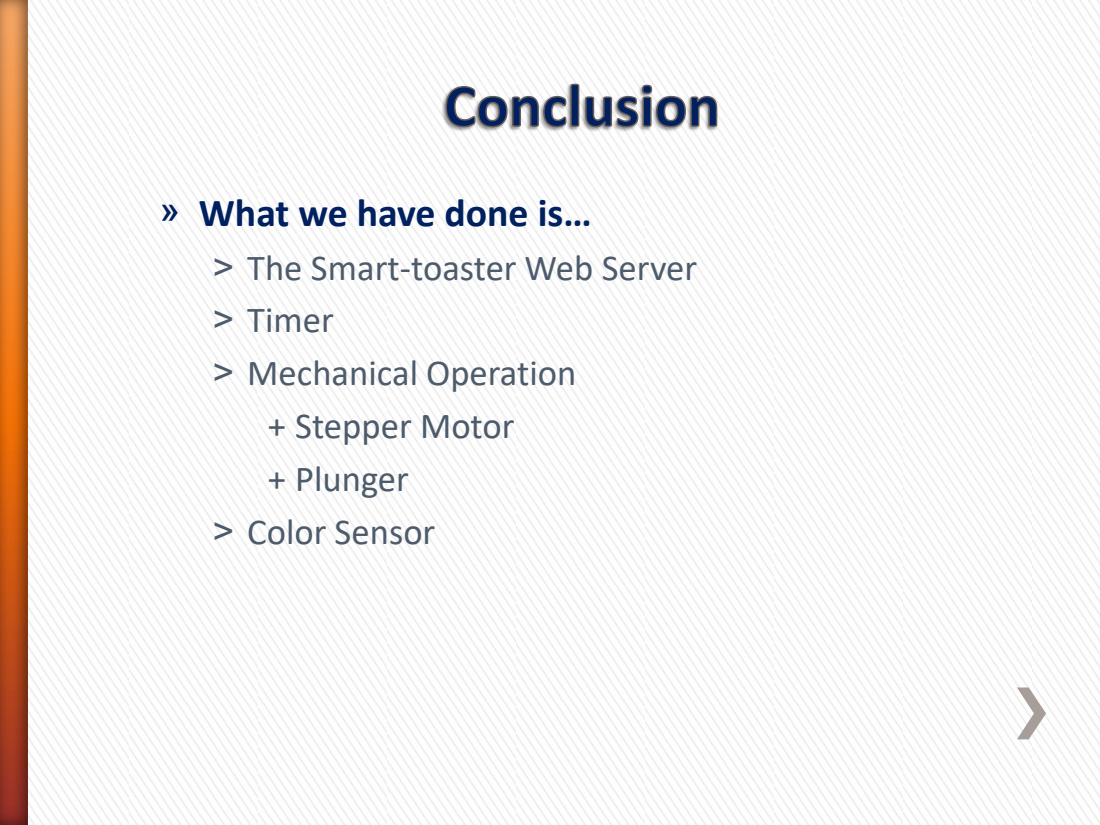
[picture p75: page 31]

» What we have done is…
˃ The Smart-toaster Web Server
˃ Timer
˃ Mechanical Operation
+ Stepper Motor
+ Plunger
˃ Color Sensor

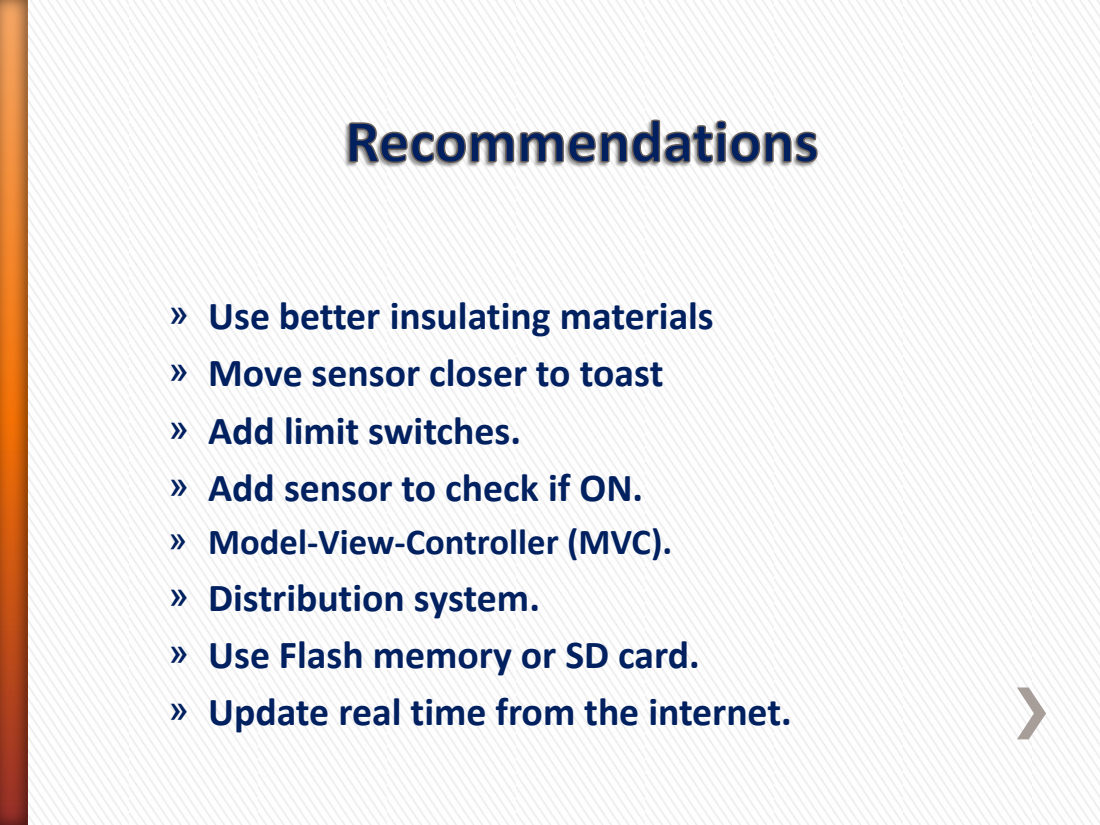
[picture p76: page 32]

» Use better insulating materials
» Move sensor closer to toast
» Add limit switches.
» Add sensor to check if ON.
» Model-View-Controller (MVC).
» Distribution system.
» Use Flash memory or SD card.
» Update real time from the internet.

» Demonstration
» Q&A
