digital0wave/digital0wave.github.smtoaster/Doc/arduino-ethernet-schematic.pdf

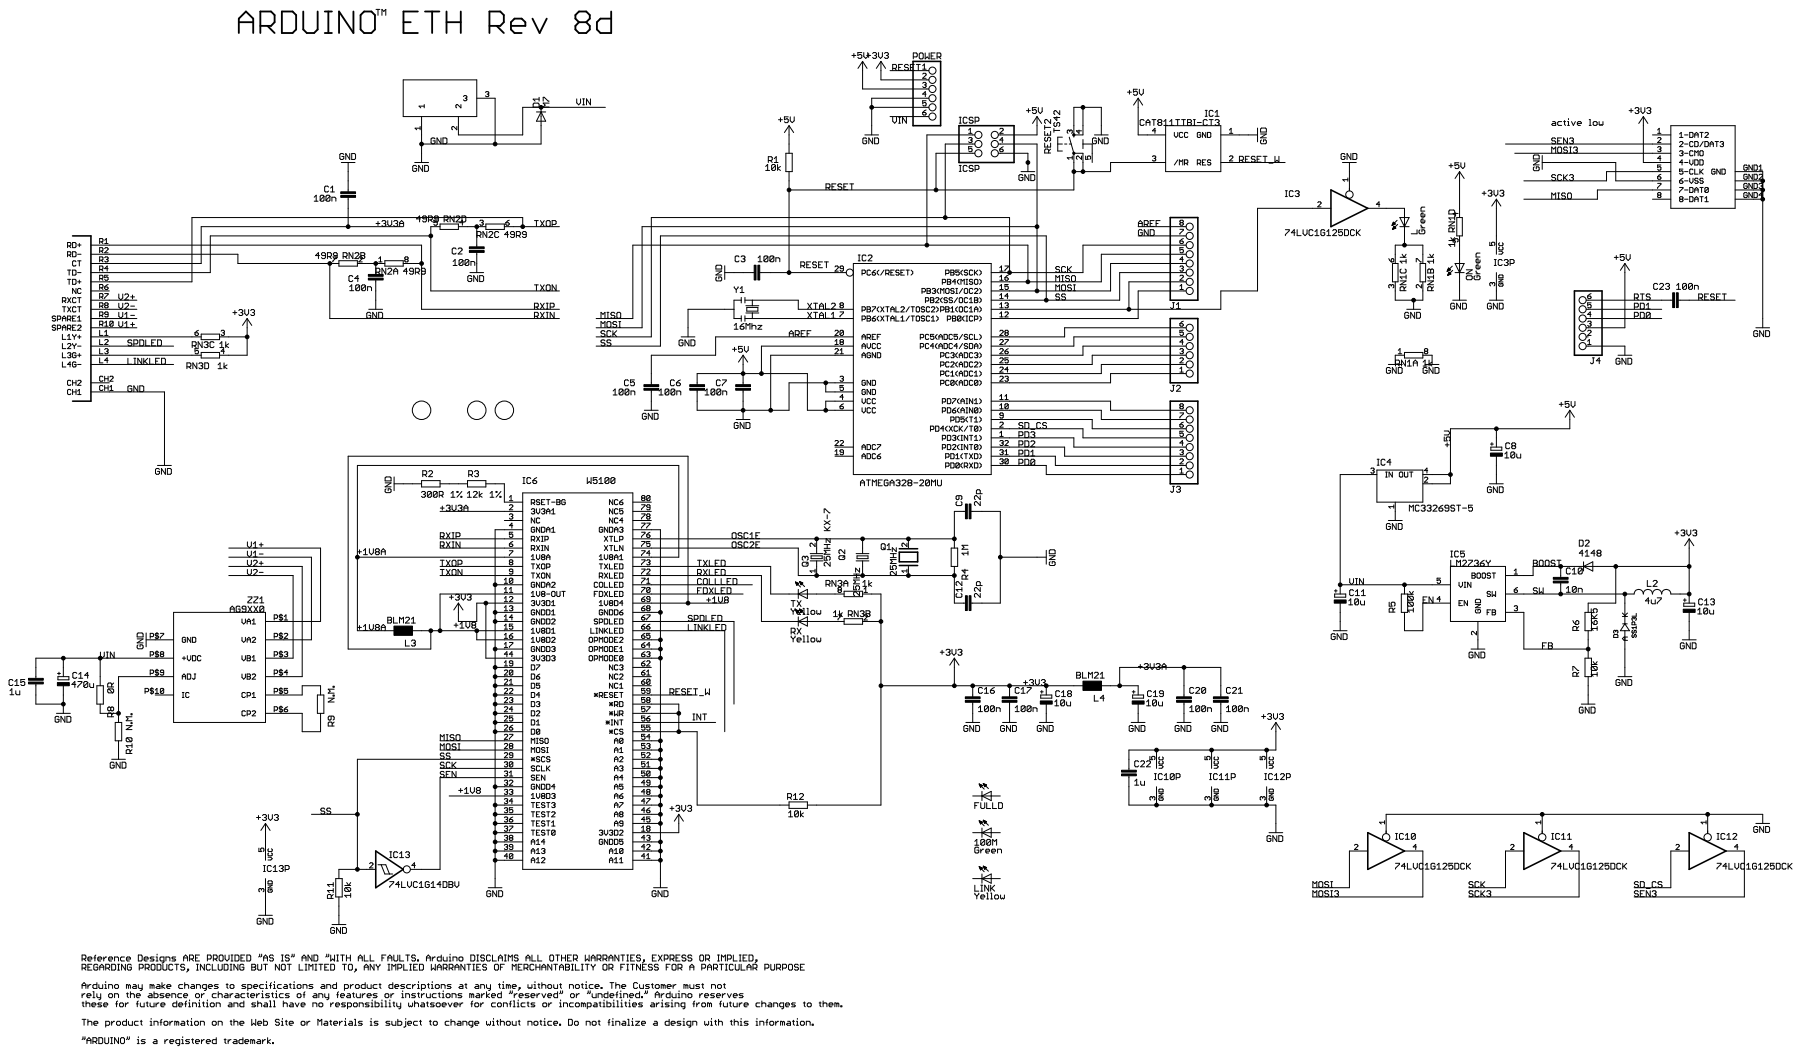
[picture p77: page 1]
